Ytelse/pcb/DMPro16/Project Outputs for DMPro16/BOM documents/BOM/Modified Bill of Materials.csv

Quantity per card | Total quantity to order | Supplier 1 | Supplier Part Number 1 | Description | Supplier webpage
1 | 5 | Digikey | 1175-1612-ND | Box Header, Pitch 2.54 mm, 2x10 Position, Height 9 mm, Tail Length 3 mm | http://www.digikey.com/product-detail/en/cnc-tech/3020-20-0100-00/1175-1612-ND/3441738
n/a | 4 | Digikey | S2221E-36-ND | Breakaway dual row header | http://www.digikey.com/product-detail/en/sullins-connector-solutions/PBC36DFBN/S2221E-36-ND/861382
n/a | 10 | Digikey | S1211EC-40-ND | Breakaway single row header | http://www.digikey.com/product-detail/en/sullins-connector-solutions/PRPC040SFAN-RC/S1211EC-40-ND/2775334
1 | 10 | Digi-Key | P12.0KHCT-ND | 12K 0.1W 1% 0603 (1608 Metric) SMD | http://www.digikey.com/product-search/en?keywords=P12.0KHCT-ND
1 | 10 | Digi-Key | P20.0KHCT-ND | 20K 0.1W 1% 0603 (1608 Metric) SMD | http://www.digikey.com/product-search/en?keywords=P20.0KHCT-ND
1 | 5 | Digi-Key | WM17469-ND | 2 x 7 2mm pitch vertical header | http://www.digikey.com/product-search/en?keywords=WM17469-ND
1 | 10 | Digi-Key | P300KHCT-ND | 300K 0.1W 1% 0603 (1608 Metric) SMD | http://www.digikey.com/product-search/en?keywords=P300KHCT-ND
1 | 5 | Digi-Key | 732-3833-5-ND | WS-DITV 2.54 mm Compact THT Dip Switch with Raised Actuator | http://www.digikey.com/product-search/en?keywords=732-3833-5-ND
1 | 10 | Digi-Key | P45.3KHCT-ND | 45K3 0.1W 1% 0603 (1608 Metric) SMD | http://www.digikey.com/product-search/en?keywords=P45.3KHCT-ND
1 | 10 | Digi-Key | P6.65KHCT-ND | 6K65 0.1W 1% 0603 (1608 Metric) SMD | http://www.digikey.com/product-search/en?keywords=P6.65KHCT-ND
1 | 10 | Digi-Key | P820GCT-ND | 820R 0.1W 5% 0603 (1608 Metric) SMD | http://www.digikey.com/product-search/en?keywords=P820GCT-ND
1 | 10 | Digi-Key | 445-7486-1-ND | CAP 10uF 10V ±10% 0603 (1608 Metric) Thickness 1mm SMD | http://www.digikey.com/product-search/en?keywords=445-7486-1-ND
1 | 10 | Digi-Key | 311-1444-1-ND | CAP 1uF 16V ±10% 0603 (1608 Metric) Thickness 1mm SMD | http://www.digikey.com/product-search/en?keywords=311-1444-1-ND
1 | 5 | Digi-Key | 768-1007-1-ND | USB UART Asynchronous Serial Data Transfer Chip, SSOP-28, Tape and Reel | http://www.digikey.com/product-search/en?keywords=768-1007-1-ND
1 | 6 | Digi-Key | 631-1185-1-ND | 24 MHz oscillator | http://www.digikey.com/product-search/en?keywords=631-1185-1-ND
1 | 5 | Digi-Key | LT6700HVCS6-3#TRMPBFCT-ND | Micropower, Low Voltage, Comparator with 400 mV Reference, 2 Channels, 1.4 to 36 V, -40 to +85 degC, 6-pin TSOT-23 (S6), Tape and Reel | http://www.digikey.com/product-search/en?keywords=LT6700HVCS6-3%23TRMPBFCT-ND
1 | 5 | Digi-Key | 557-1562-ND | 128 Mb (x1/x2/x4) Serial NOR Flash Memory with Multi I/O, 108 MHz, 2.7 to 3.6 V, 8-pin SO8 Wide (SE), Tray | http://www.digikey.com/product-search/en?keywords=557-1562-ND
1 | 5 | Digi-Key | 277-1667-ND | Socket, Screw Terminal Block, 2 Way, 5.0 mm Pitch, 90 Degree Angle, Through-Hole | http://www.digikey.com/product-search/en?keywords=277-1667-ND
1 | 6 | Digi-Key | 296-23557-1-ND | Advanced USB Transceiver, Full Speed, Single, +/-15 KV, -40 to 85 degC, 14-Pin TSSOP (PW) | http://www.digikey.com/product-search/en?keywords=296-23557-1-ND
1 | 6 | Digi-Key | USB3300-EZK-CT-ND | Hi-Speed USB Host, Device or OTG PHY with ULPI Low Pin Interface, 5 pF, -40 to 85 degC, 32-Pin QFN (QFN-3304), RoHS, Tape and Reel | http://www.digikey.com/product-search/en?keywords=USB3300-EZK-CT-ND
12 | 60 | Digi-Key | 478-7943-1-ND | CAP 4.7uF 10V ±10% 0603 (1608 Metric) Thickness 1mm SMD | http://www.digikey.com/product-search/en?keywords=478-7943-1-ND
16 | 80 | Digi-Key | 541-470GCT-ND | 470R 0.1W 5% 0603 (1608 Metric) SMD | http://www.digikey.com/product-search/en?keywords=541-470GCT-ND
17 | 85 | Digi-Key | 732-4978-1-ND | SMD mono-color Chip LED, WL-SMCW, Red | http://www.digikey.com/product-search/en?keywords=732-4978-1-ND
2 | 20 | Digi-Key | 541-15GCT-ND | 15R 0.1W 5% 0603 (1608 Metric) SMD | http://www.digikey.com/product-search/en?keywords=541-15GCT-ND
2 | 20 | Digi-Key | 541-1.20KHCT-ND | 1K2 0.1W 1% 0603 (1608 Metric) SMD | http://www.digikey.com/product-search/en?keywords=541-1.20KHCT-ND
2 | 20 | Digi-Key | P1.8KGCT-ND | 1K8 0.1W 5% 0603 (1608 Metric) SMD | http://www.digikey.com/product-search/en?keywords=P1.8KGCT-ND
2 | 20 | Digi-Key | P200GCT-ND | 200R 0.1W 5% 0603 (1608 Metric) SMD | http://www.digikey.com/product-search/en?keywords=P200GCT-ND
22 | 110 | Digi-Key | 311-1776-1-ND | CAP 100nF 16V ±5% 0603 (1608 Metric) Thickness 1mm SMD | http://www.digikey.com/product-search/en?keywords=311-1776-1-ND
3 | 30 | Digi-Key | P4.7KGCT-ND | 4K7 0.1W 5% 0603 (1608 Metric) SMD | http://www.digikey.com/product-search/en?keywords=P4.7KGCT-ND
3 | 15 | Digi-Key | SW415-ND | Sealed Tactile Switch, SPST-NO, 3 to 24 V, -25 to 70 degC, 4-Pin SMD, RoHS, Bulk | http://www.digikey.com/product-search/en?keywords=SW415-ND
3 | 30 | Digi-Key | 478-6208-1-ND | CAP 10nF 16V ±1% 0603 (1608 Metric) Thickness 1mm SMD | http://www.digikey.com/product-detail/en/avx-corporation/0603YC103JAT2A/478-6208-1-ND/2391407
3 | 30 | Digi-Key | 445-7474-1-ND | CAP 2.2uF 16V ±10% 0603 (1608 Metric) Thickness 0.55mm SMD | http://www.digikey.com/product-search/en?keywords=445-7474-1-ND
3 | 15 | Digi-Key | LP38501TS-ADJ-ND | 3A FlexCap Low Dropout Linear Regulator for 2.7V to 5.5V Inputs, 5-pin TO-263, Pb-Free | http://www.digikey.com/product-search/en?keywords=LP38501TS-ADJ-ND
4 | 30 | Digi-Key | 541-33GCT-ND | 33R 0.1W 5% 0603 (1608 Metric) SMD | http://www.digikey.com/product-search/en?keywords=541-33GCT-ND
4 | 30 | Digi-Key | P4.70KHCT-ND | 4K7 0.1W 1% 0603 (1608 Metric) SMD | http://www.digikey.com/product-search/en?keywords=P4.70KHCT-ND
4 | 30 | Digi-Key | 445-9050-1-ND | CAP 4.7uF 16V ±10% 0603 (1608 Metric) Thickness 1mm SMD | http://www.digikey.com/product-detail/en/tdk-corporation/C1608X5R1E475K080AC/445-9050-1-ND/3648704
5 | 40 | Digi-Key | P100KHCT-ND | 100K 0.1W 1% 0603 (1608 Metric) SMD | http://www.digikey.com/product-search/en?keywords=P100KHCT-ND
5 | 40 | Digi-Key | 541-100GCT-ND | 100R 0.1W 5% 0603 (1608 Metric) SMD | http://www.digikey.com/product-search/en?keywords=541-100GCT-ND
5 | 40 | Digi-Key | P1.0KGCT-ND | 1K 0.1W 5% 0603 (1608 Metric) SMD | http://www.digikey.com/product-search/en?keywords=P1.0KGCT-ND
5 | 25 | Digi-Key | WM5461CT-ND | USB, MINI, SMD, RA KME04-USBMU03A01 | http://www.digikey.com/product-search/en?keywords=WM5461CT-ND
5 | 25 | Digi-Key | 568-3529-2-ND | 4 channel USB ESD protection device | http://www.digikey.com/product-search/en?keywords=568-3529-2-ND
6 | 30 | Digi-Key | 445-6007-1-ND | CAP 100uF 10V ±20% 1206 (3216 Metric) Thickness 1.9mm SMD | http://www.digikey.com/product-search/en?keywords=445-6007-1-ND
7 | 50 | Digi-Key | 541-10.0KHCT-ND | 10K 0.1W 1% 0603 (1608 Metric) SMD | http://www.digikey.com/product-search/en?keywords=541-10.0KHCT-ND
7 | 50 | Digi-Key | 311-10KGRCT-ND | 10K 0.1W 5% 0603 (1608 Metric) SMD | http://www.digikey.com/product-search/en?keywords=311-10KGRCT-ND
8 | 40 | Digi-Key | 490-3390-1-ND | 1210 100uF capacitor for artix-7 power decoupling | http://www.digikey.com/product-search/en?keywords=490-3390-1-ND
8 | 40 | Digi-Key | 541-0.0GCT-ND | Jumper 0603 (1608 Metric) | http://www.digikey.com/product-search/en?keywords=541-0.0GCT-ND
1 | 5 | Farnell | 2064067 | SD and Combo Memory Card Connector, 9 Position Surface Mount, -25 to 85 degC, RoHS, Tape and Reel | http://no.farnell.com/molex/503500-0991/connector-sd-card-push-push-smt/dp/2064067?ost=2064067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
1 | 6 | Farnell | 1641012RL | 48 MHz oscillator | http://no.farnell.com/fox-electronics/fxo-hc736r-48/osc-5x7mm-smd-cer-48-000mhz/dp/1641012
23 | 115 | Farnell | 1833805 | CAP 470nF 10V ±5% 0603 (1608 Metric) Thickness 1mm SMD | http://no.farnell.com/avx/0603zd474kat2a/cap-mlcc-x5r-470nf-10v-0603/dp/1833805?ost=1833805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
3 | 30 | Farnell | 2496834 | CAP 15pF 16V ±0.25pF 0603 (1608 Metric) Thickness 1mm SMD | http://no.farnell.com/walsin/0603b104k500ct/capacitor-mlcc-x7r-0-1uf-50v-0603/dp/2496834?ost=2496834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
5 | 35 | Farnell | 1833809 | CAP 1uF 16V ±5% 0603 (1608 Metric) Thickness 1mm SMD | http://no.farnell.com/avx/0603zg105zat2a/cap-mlcc-y5v-1uf-10v-0603/dp/1833809?ost=1833809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
1 | 6 | Farnell | 2064049 | 100 MHz oscillaor | http://no.farnell.com/fox-electronics/fxo-hc736r-100/osc-100mhz-3-3v-smd/dp/2064049
