Ytelse/pcb/DMPro16/Project Outputs for DMPro16/Documentation Output/Schematic Print/Schematic Prints.PDF

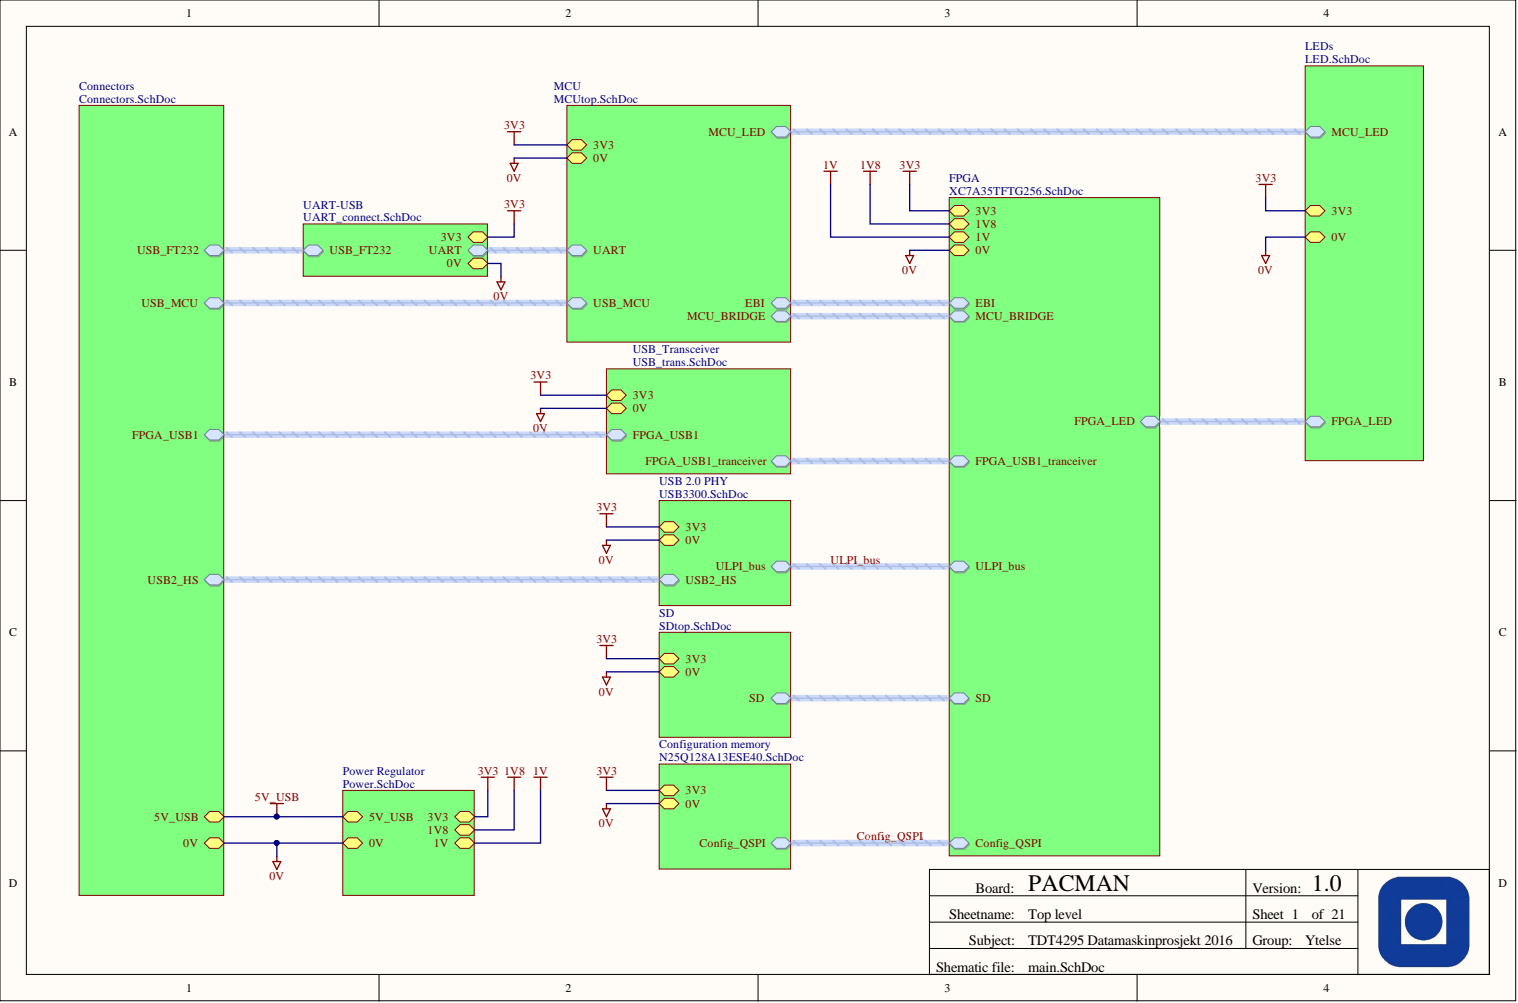
[picture p1: page 1]

5V_USB 3V3 1V8 0V 1V

Board: PACMAN | Version: 1.0

Sheetname: Top level | Sheet 1 of 21

Subject: TDT4295 Datamaskinprosjekt 2016 | Group: Ytelse

Shematic file: main.SchDoc

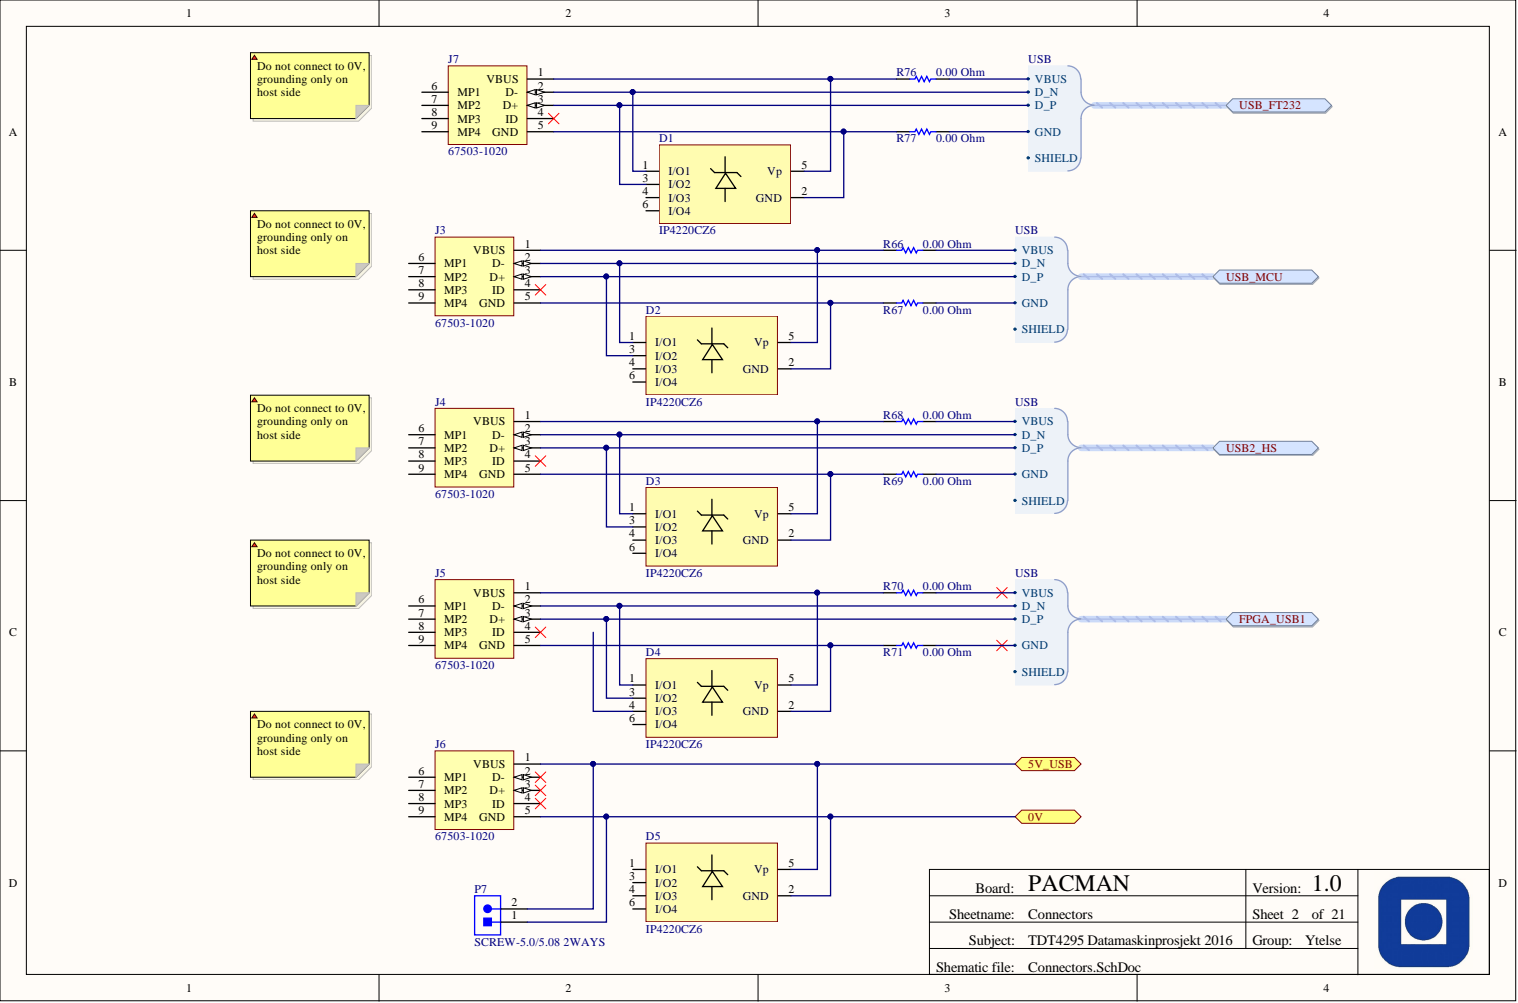
[picture p2: page 2]

Do not connect to 0V,
grounding only on
host side

Shematic file: Connectors.SchDoc

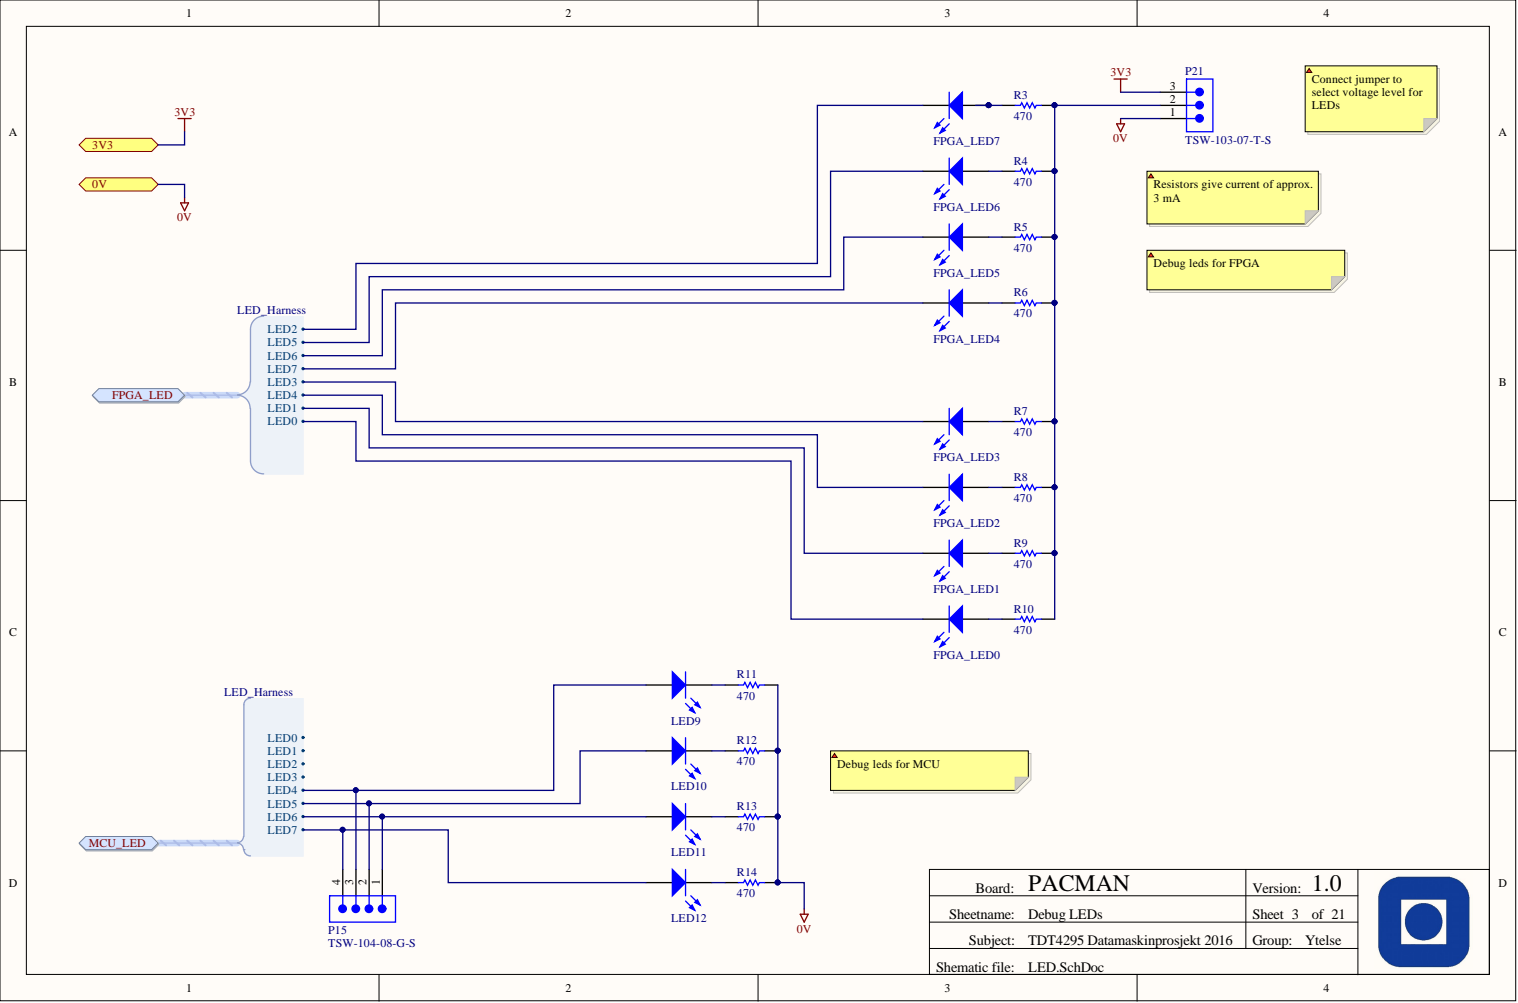
[picture p3: page 3]

Connect jumper to
select voltage level for
LEDs

Resistors give current of approx.

Debug leds for FPGA

Debug leds for MCU

Board: PACMAN | Version: 1.0

Sheetname: Debug LEDs | Sheet 3 of 21

Shematic file: LED.SchDoc

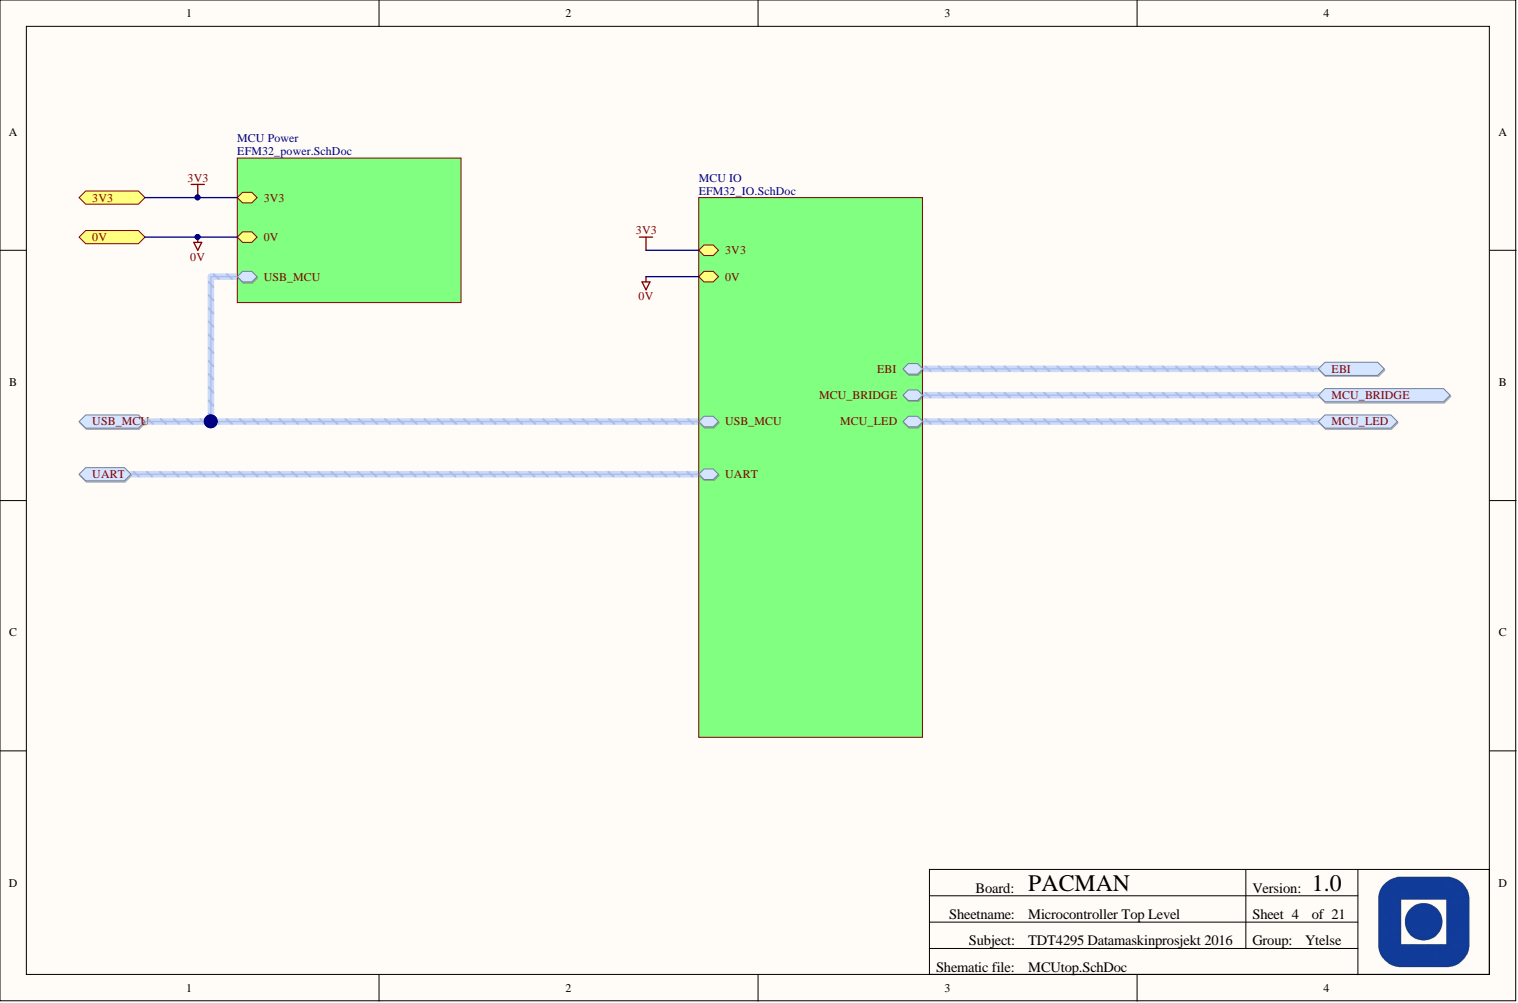
[picture p4: page 4]

: PACMAN Bo ard | : 1.0 V ersio n

S h e etn am e : Micro c o ntroller To p Le v e l | S h e e t 4 o f 2 1

u bje ct: TDT4 5 D ata askin prosje kt 2 | Gro p Ytelse

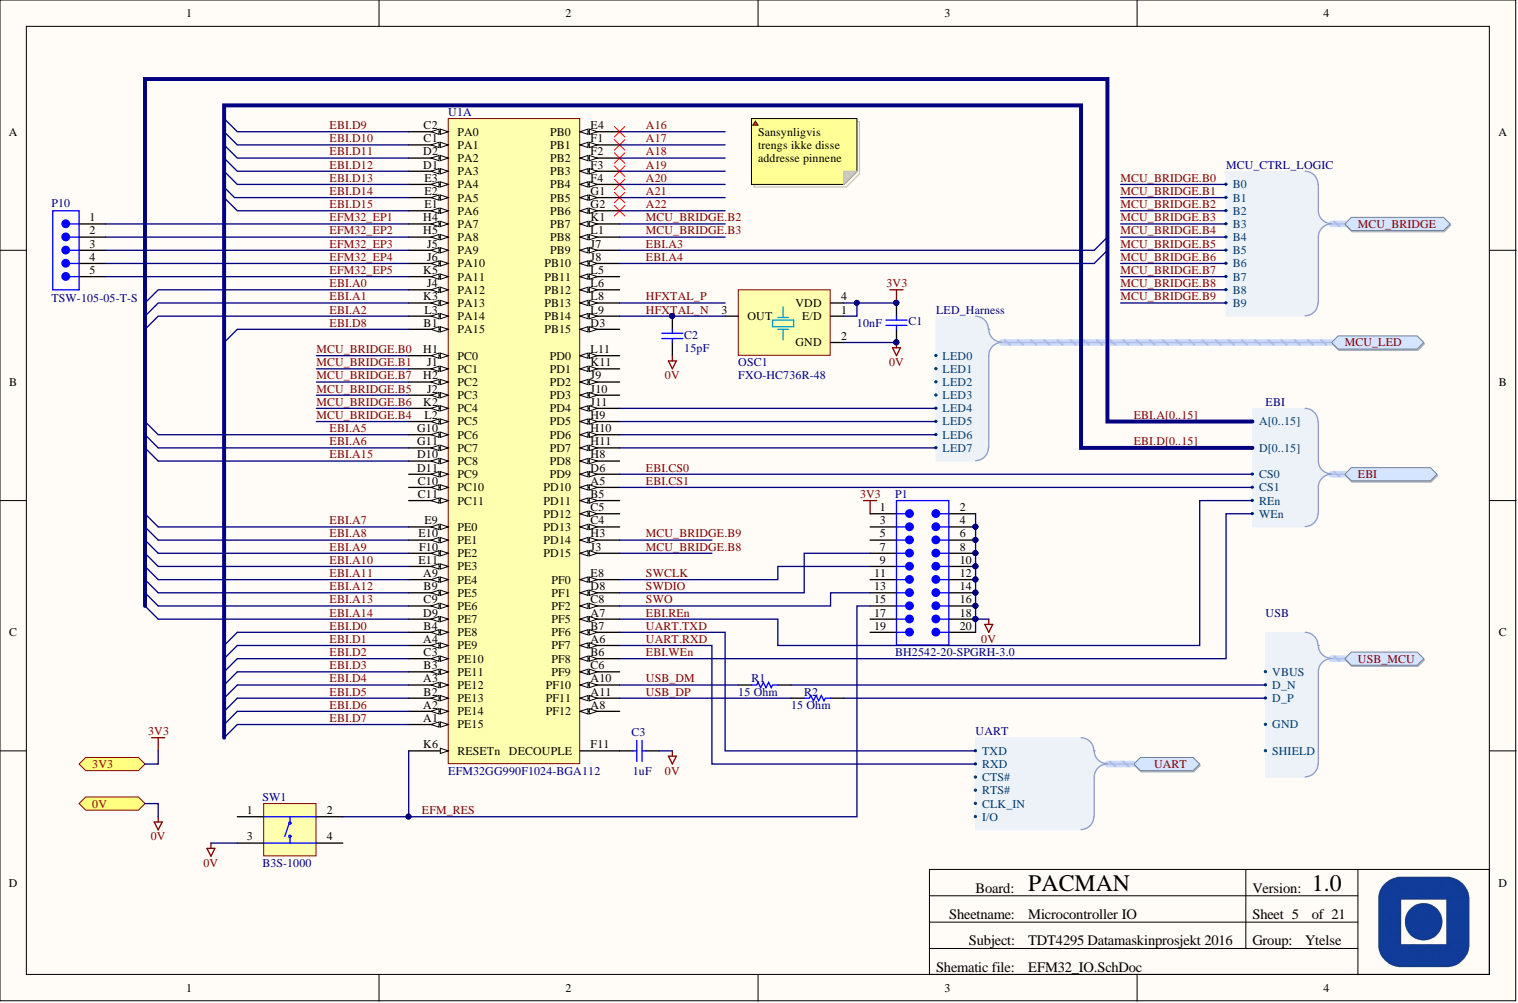
[picture p5: page 5]

EBI.CS0 EBI.CS1 EBI.WEn EBI.REn

MCU _BRID G E.B9 MCU _BRID G E.B8 | 3 5 7 | | 4 6 8 1 0 1 2 1 4 1 6

EBI.A | 1 4 D 9 | PE 7 PF5 8 B4 PF6 PE PE 9 PF7 0 C3 PF8 PE 1 1 B3 PF9 PE 1 PE 1 2 PF1 0 3 B2 PE 1 PF1 1 PE 1 4 PF1 2 PE 1 5 | A 7 | | 1 7 1 9 | 1 8 2 0
EBI.D EBI.D EBI.D EBI.D | 0 1 A 4 2 3 4 A 3 5 6 A 2 1 7 A | | B7 | U ART.T X D

A 6 | U ART.RX D

B6 | | | BH 2 5 4 2-2
C6 | USB_ D M R1 USB_ D P 1 5 O h m R2 1 5 O h m C3 | | U ART

: PACMAN Bo ard | : 1.0 V ersio n

S h e etn am e : Micro c o ntroller IO | S h e e t 5 o f 2 1

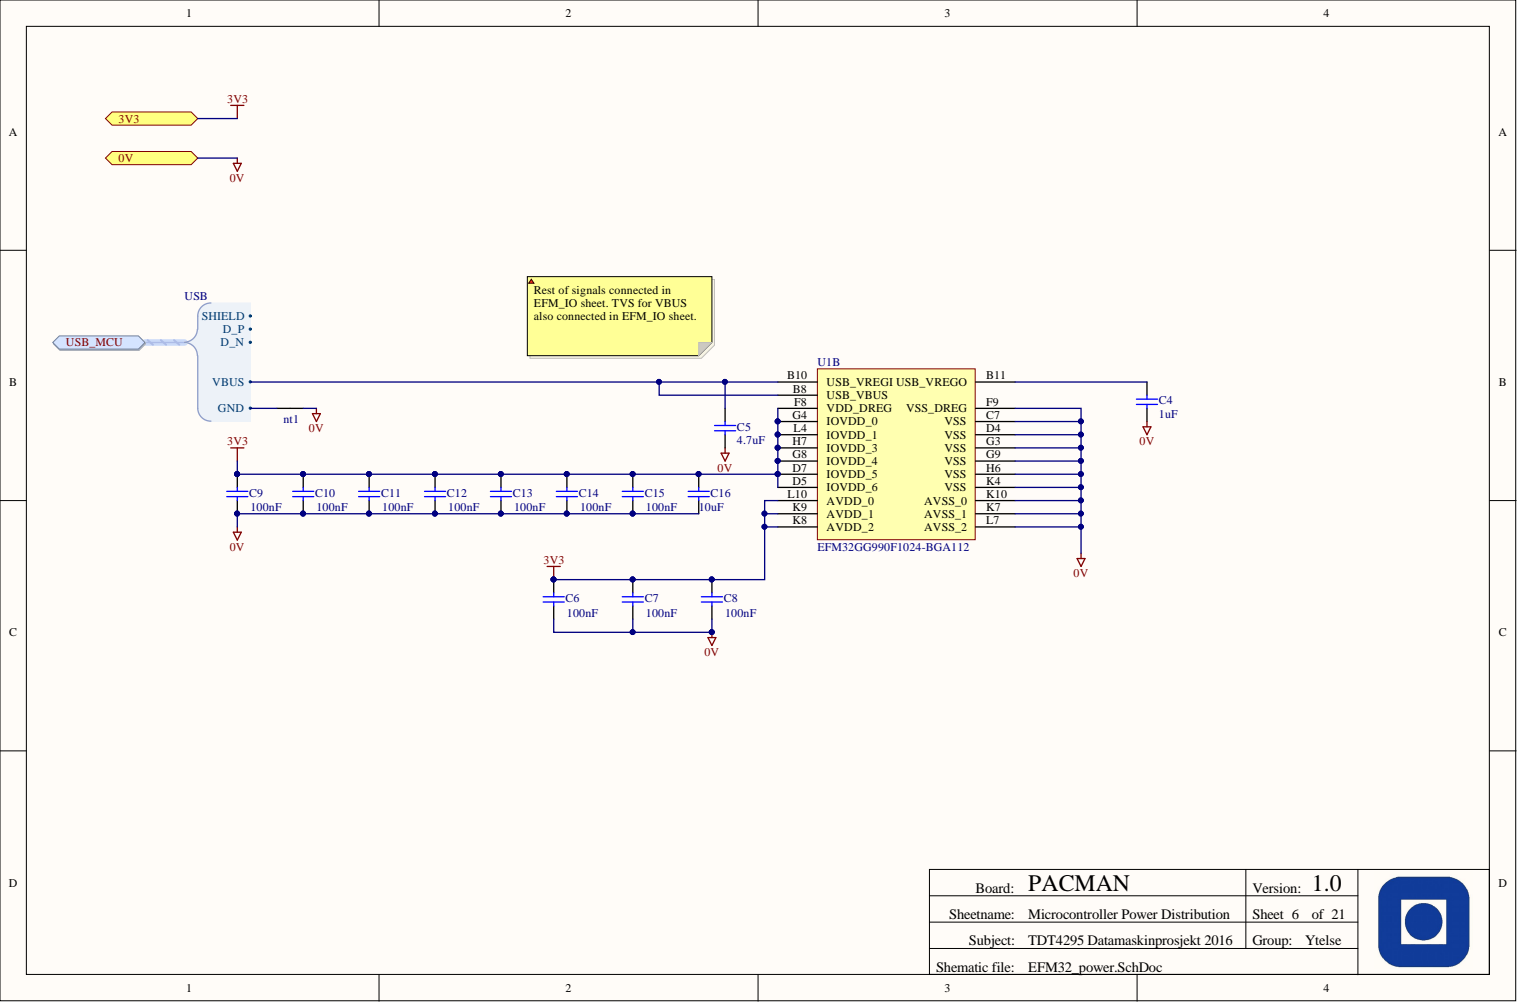
[picture p6: page 6]

Rest of signals connected in
EFM_IO sheet. TVS for VBUS
also connected in EFM_IO sheet.

Board: PACMAN | Version: 1.0

Sheetname: Microcontroller Power Distribution | Sheet 6 of 21

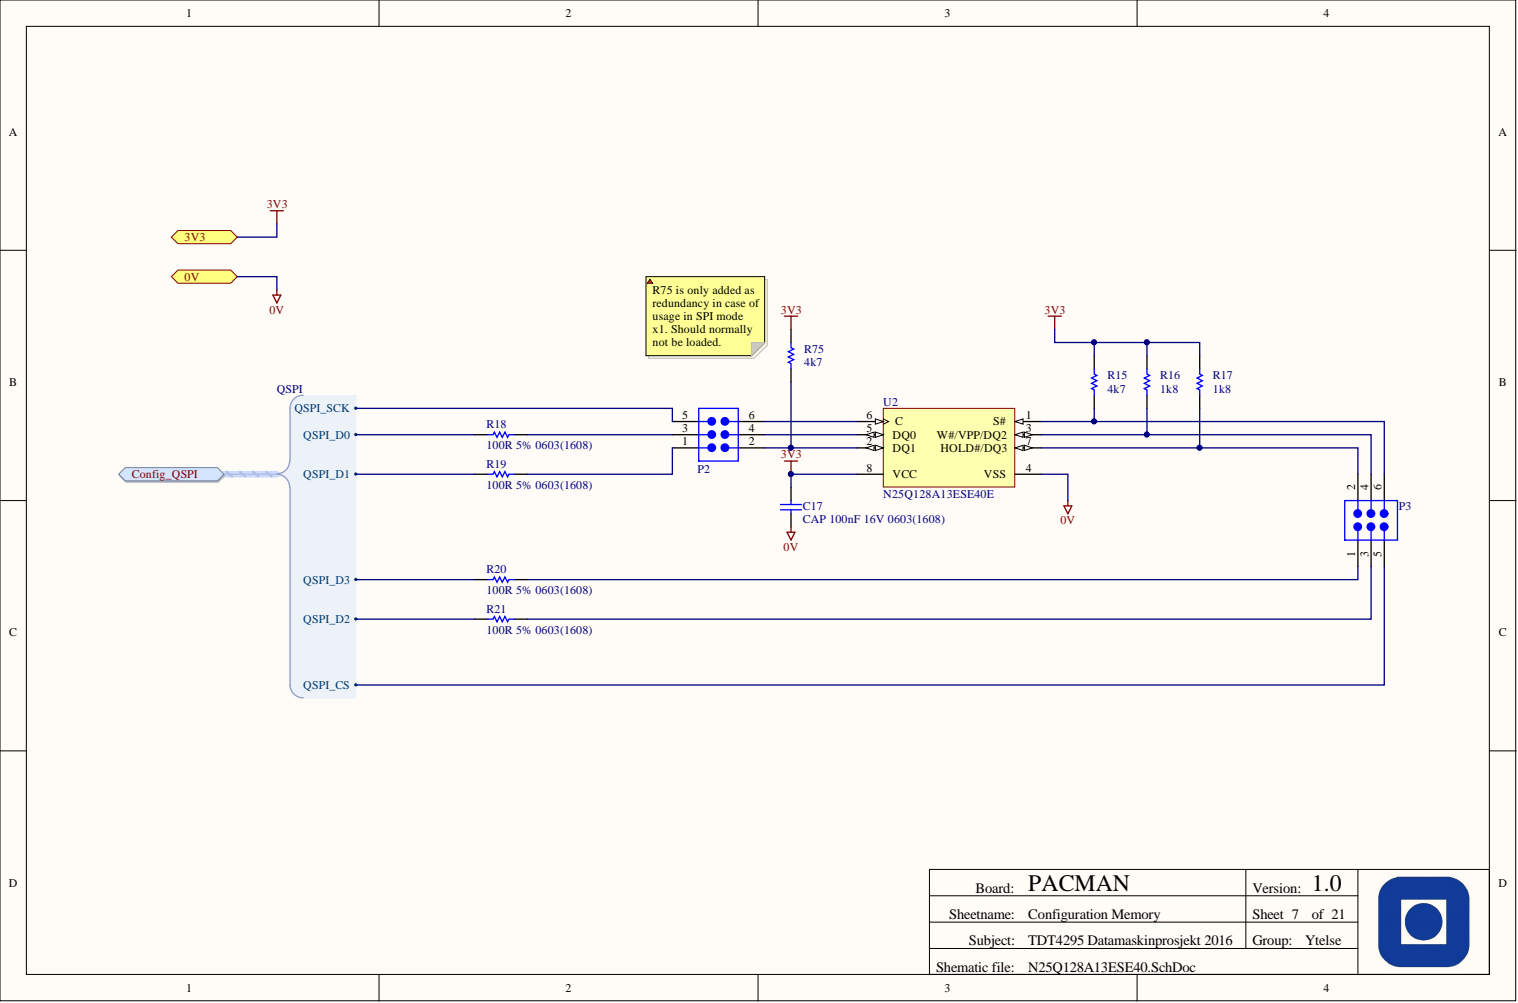
[picture p7: page 7]

: PACMAN Bo ard | : 1.0 V ersio n

S h e etn am e : Co nfig uratio n M e m ory | S h e e t 7 o f 2 1

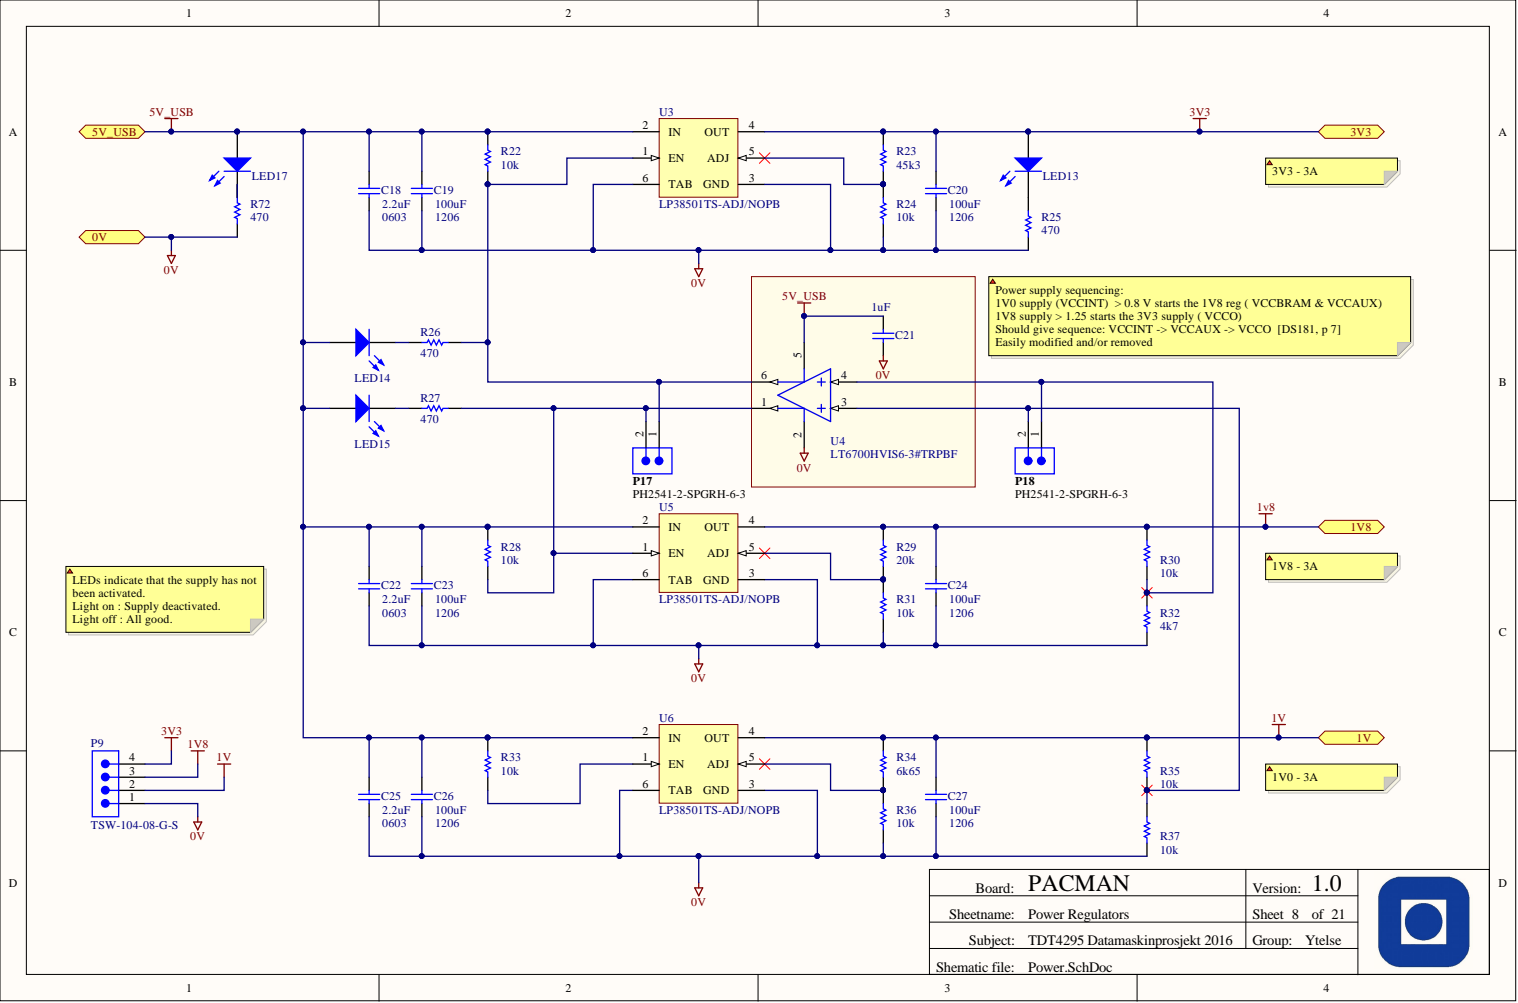
[picture p8: page 8]

R2 8 | 1
1 0 k | 6 | 3

R3 3 | 1
1 0 k | 6 | | 3

: PACMAN Bo ard | : 1.0 V ersio n

S h e etn am e : P o w er Re g ulators | S h e e t 8 o f 2 1

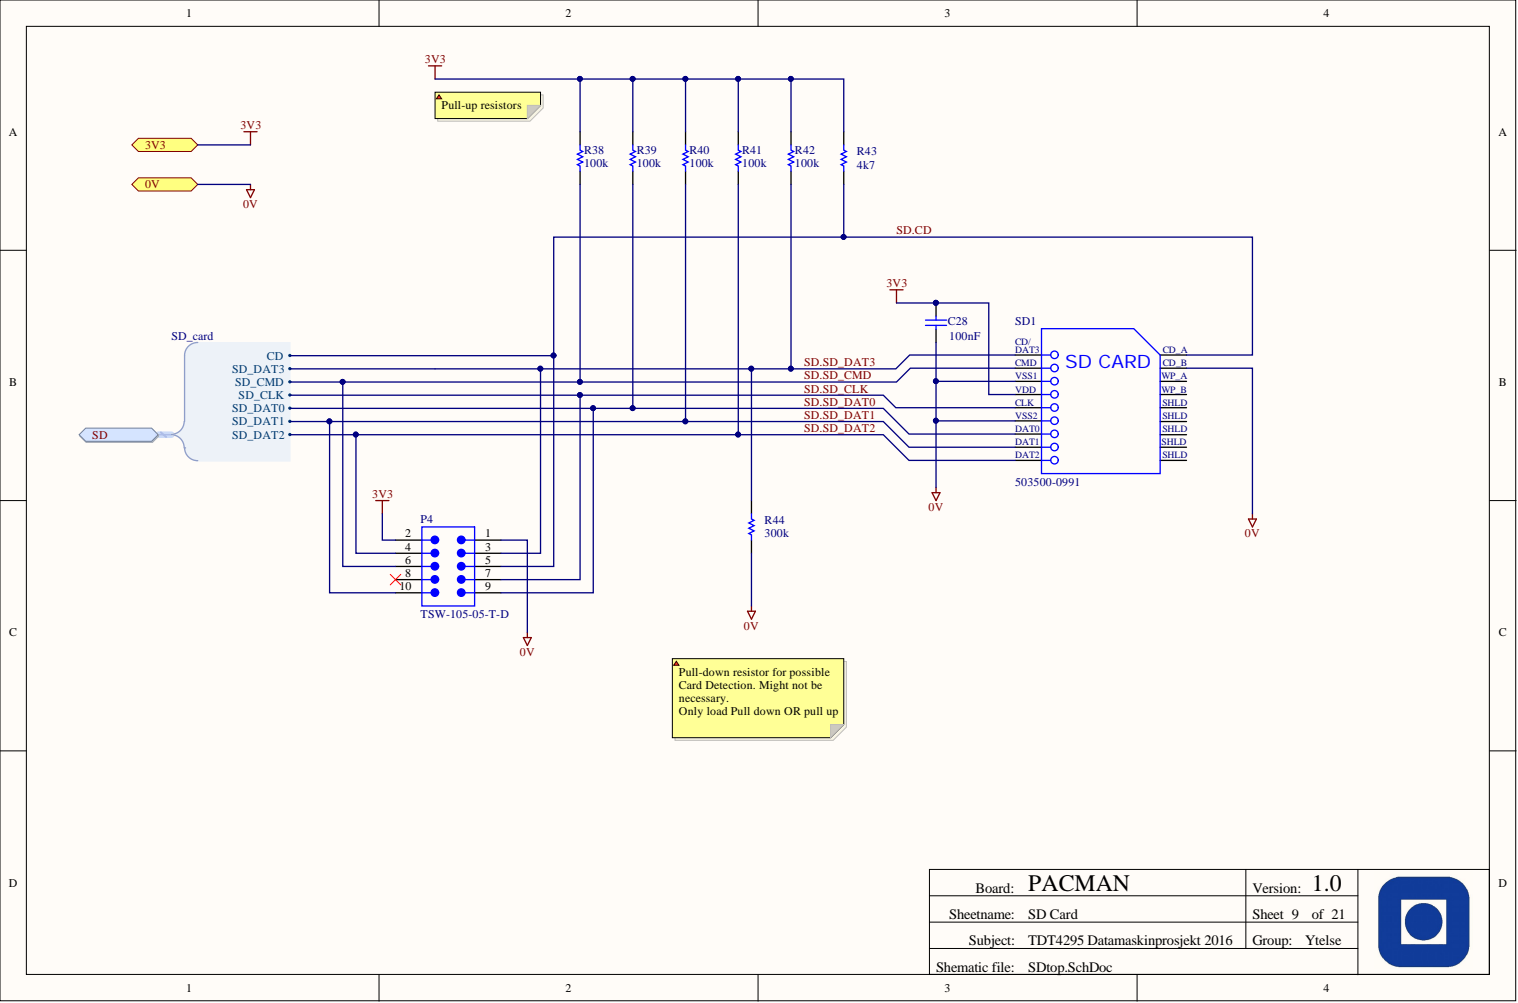
[picture p9: page 9]

Pull-down resistor for possible
Card Detection. Might not be
necessary.
Only load Pull down OR pull up

Board: PACMAN | Version: 1.0

Sheetname: SD Card | Sheet 9 of 21

Shematic file: SDtop.SchDoc

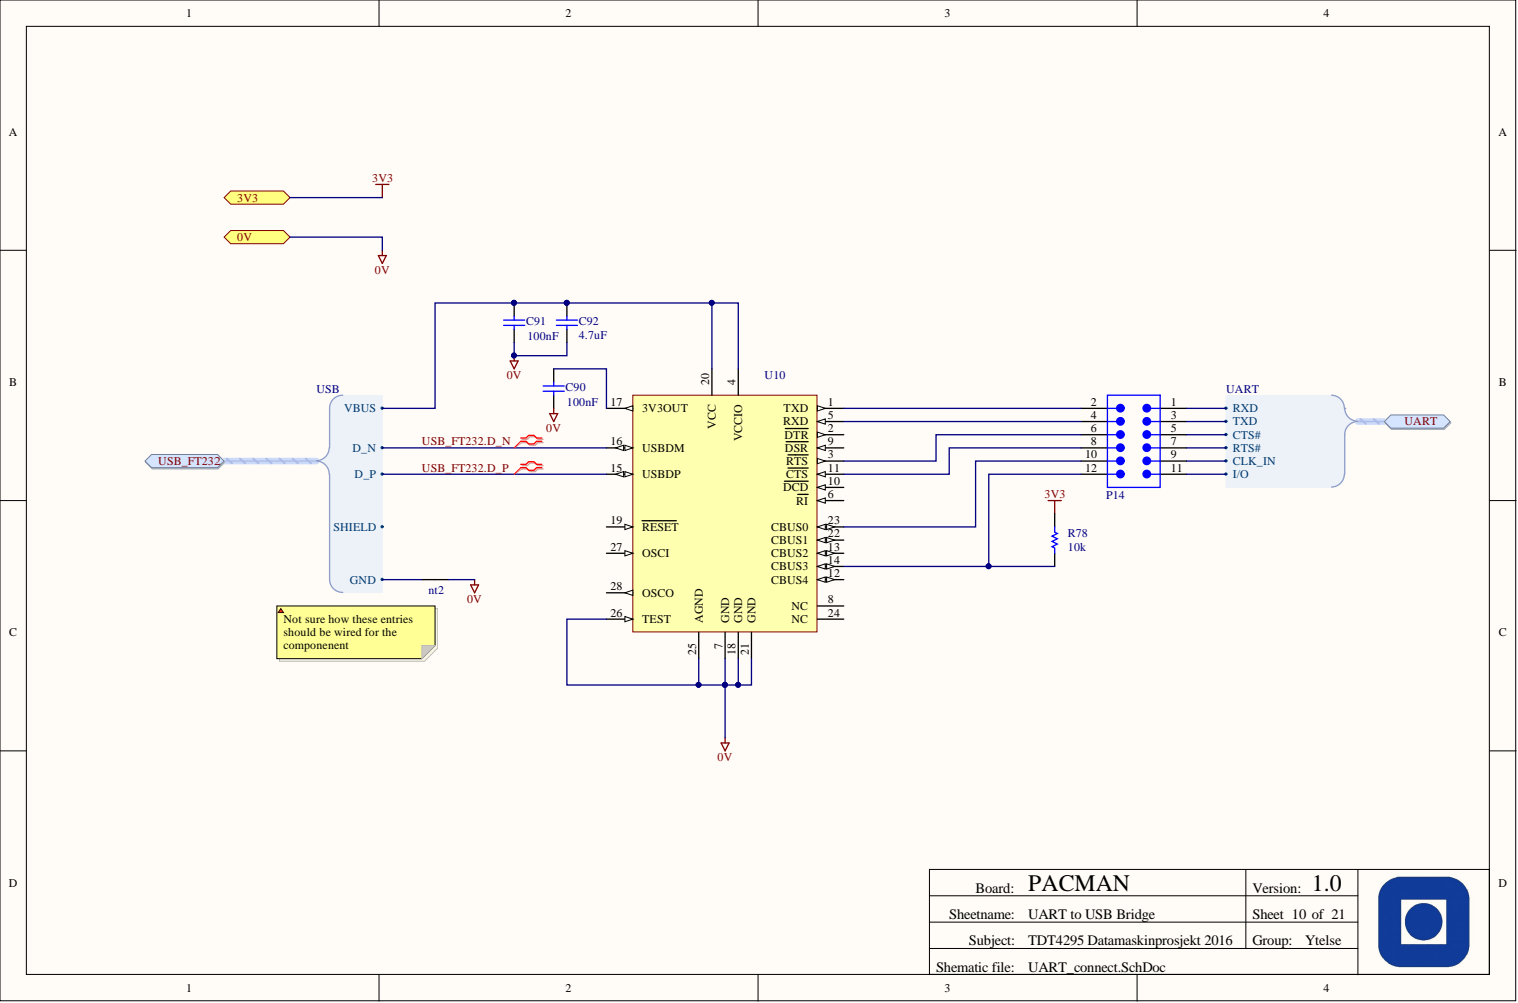
[picture p10: page 10]

: PACMAN Bo ard | : 1.0 V ersio n

S h e etn am e : U ART to U SB Brid g e | S h e e t 1 0 o f 2 1

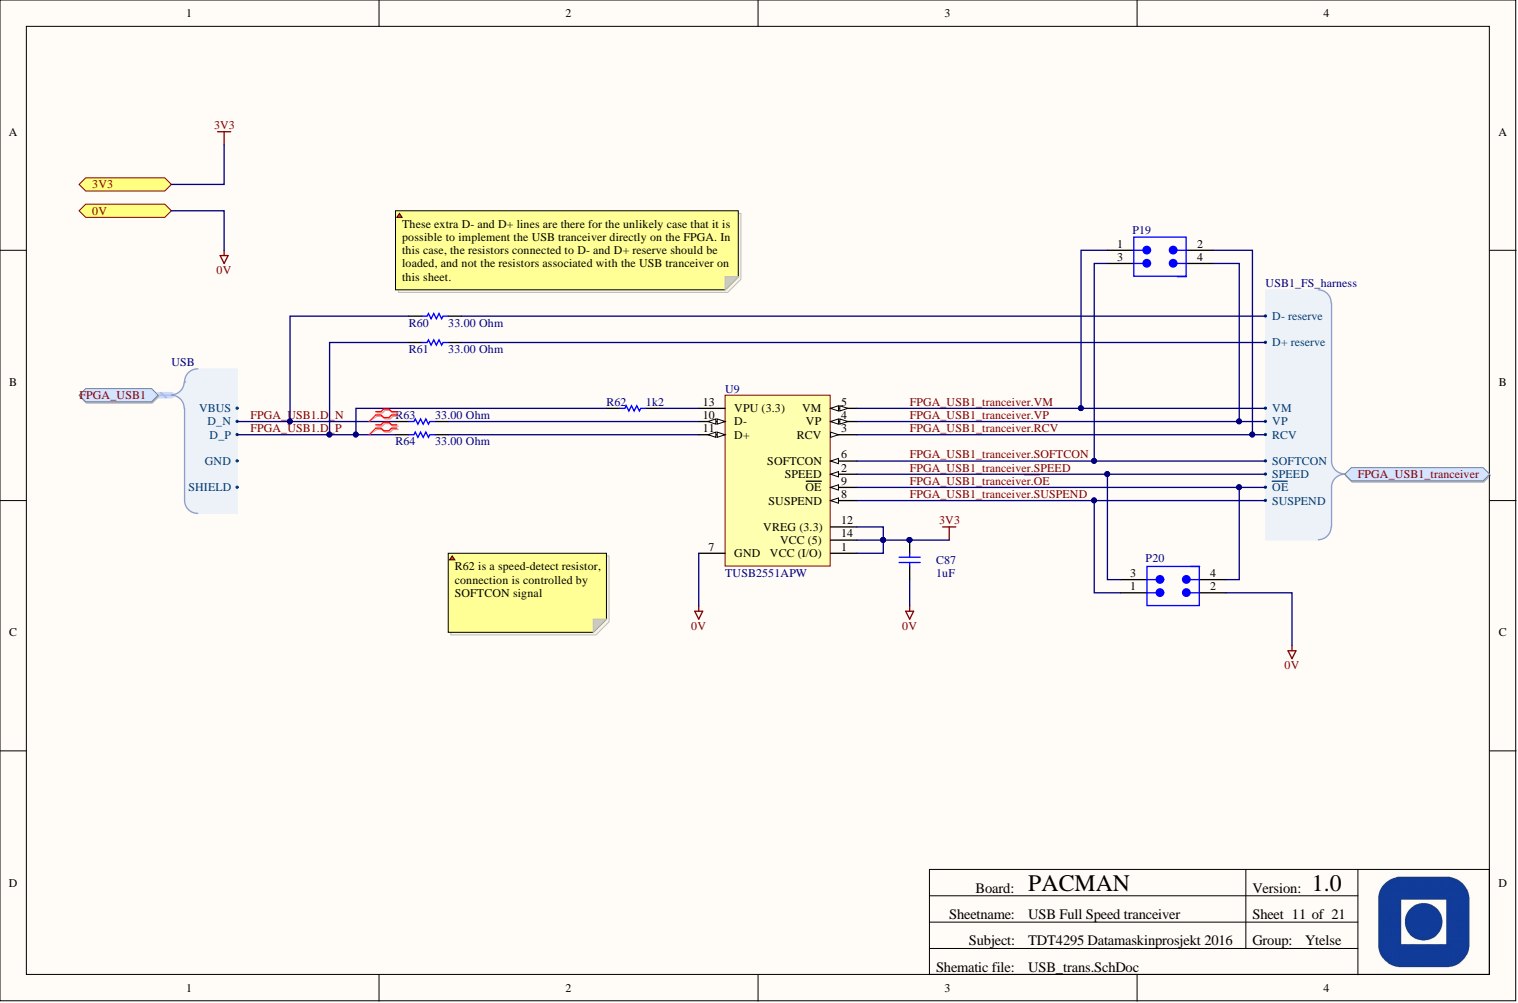
[picture p11: page 11]

These extra D- and D+ lines are there for the unlikely case that it is
possible to implement the USB tranceiver directly on the FPGA. In
this case, the resistors connected to D- and D+ reserve should be
loaded, and not the resistors associated with the USB tranceiver on
this sheet.

R62 is a speed-detect resistor,
connection is controlled by
SOFTCON signal

Board: PACMAN | Version: 1.0

Sheetname: USB Full Speed tranceiver | Sheet 11 of 21

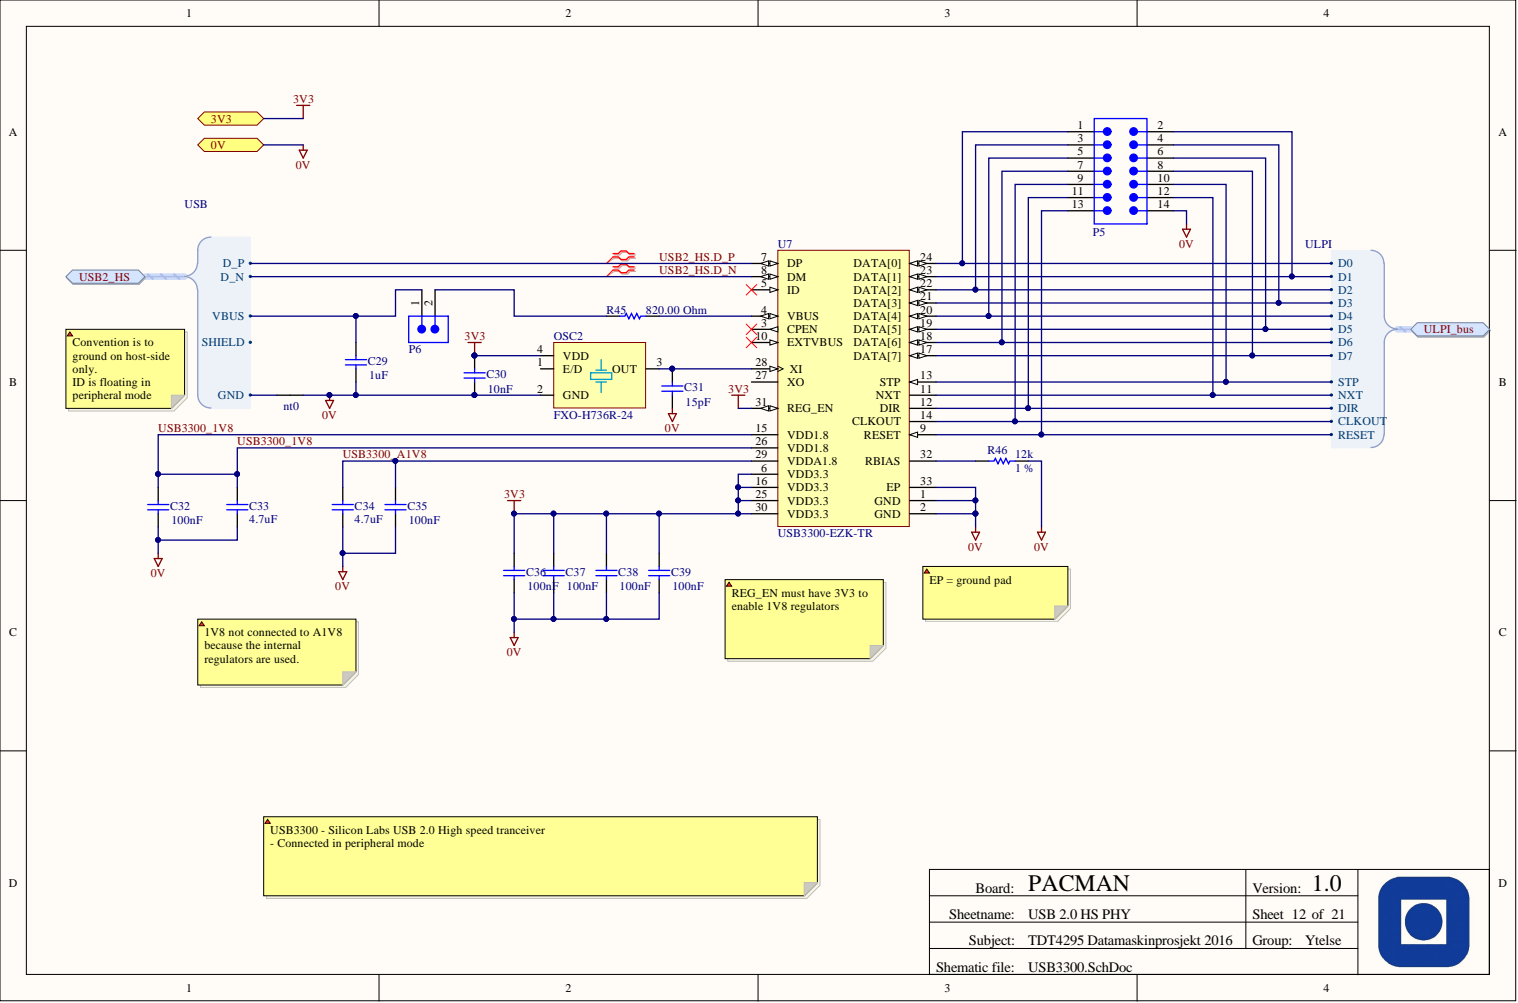
[picture p12: page 12]

1 0
1 2
1 4

USB3 3 0 0 _ 1 V 8 | 2 6

6 | 3 3
1 6
2 5 | 1
3 0 | 2

: PACMAN Bo ard | : 1.0 V ersio n

S h e etn am e : U SB 2.0 H S P H Y | S h e e t 1 2 o f 2 1

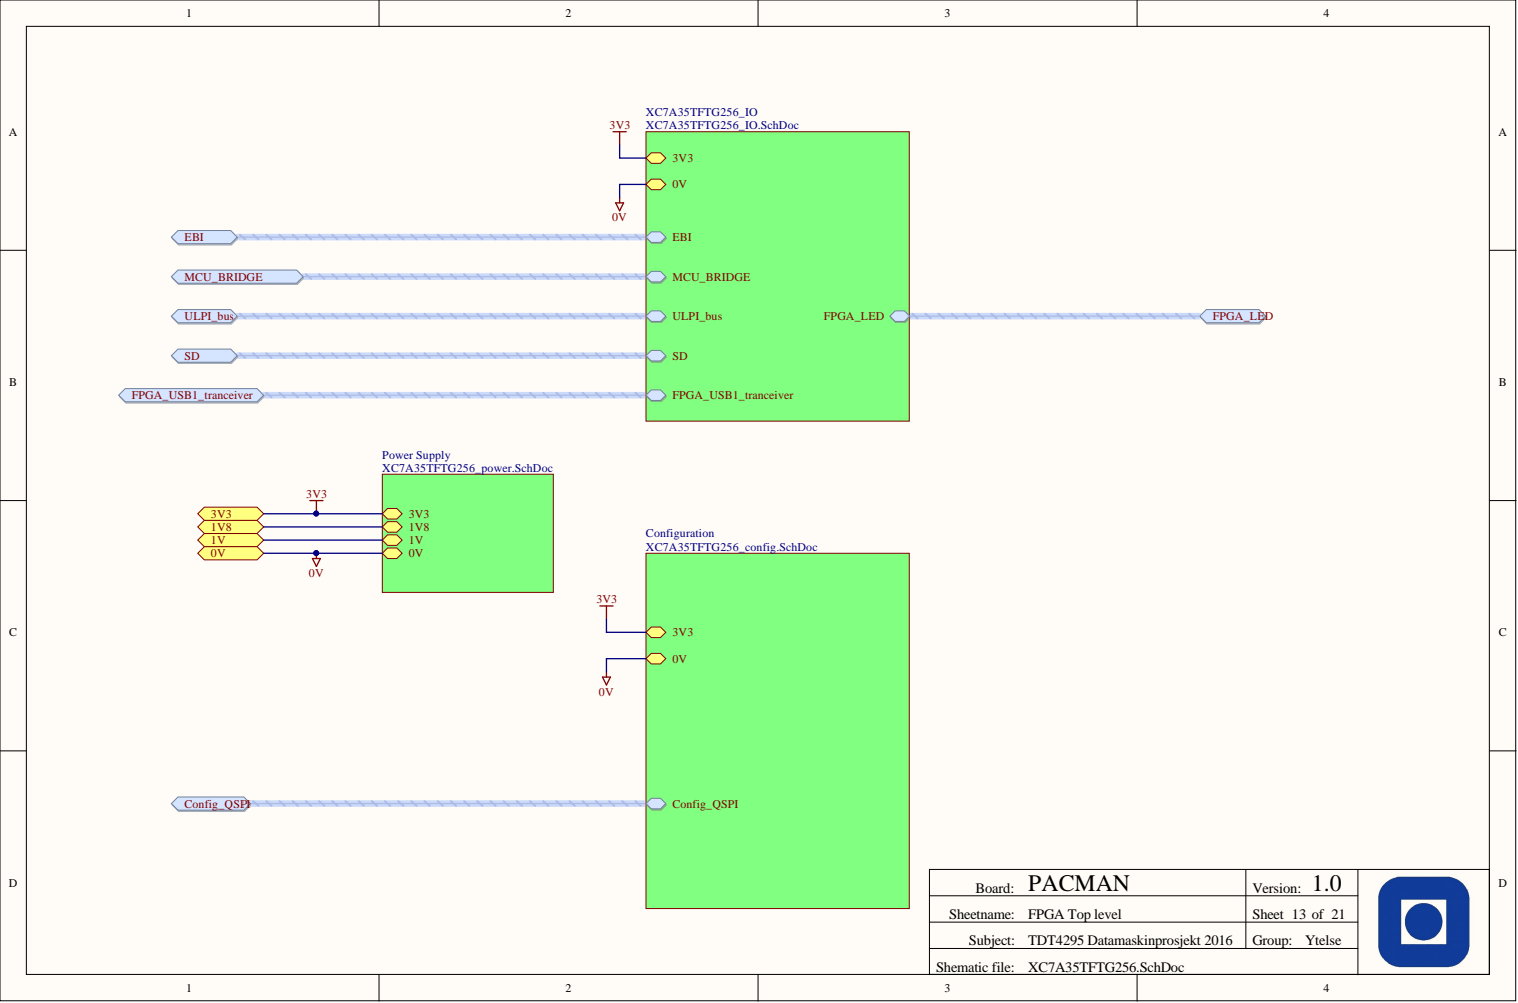
[picture p13: page 13]

Board: PACMAN | Version: 1.0

Sheetname: FPGA Top level | Sheet 13 of 21

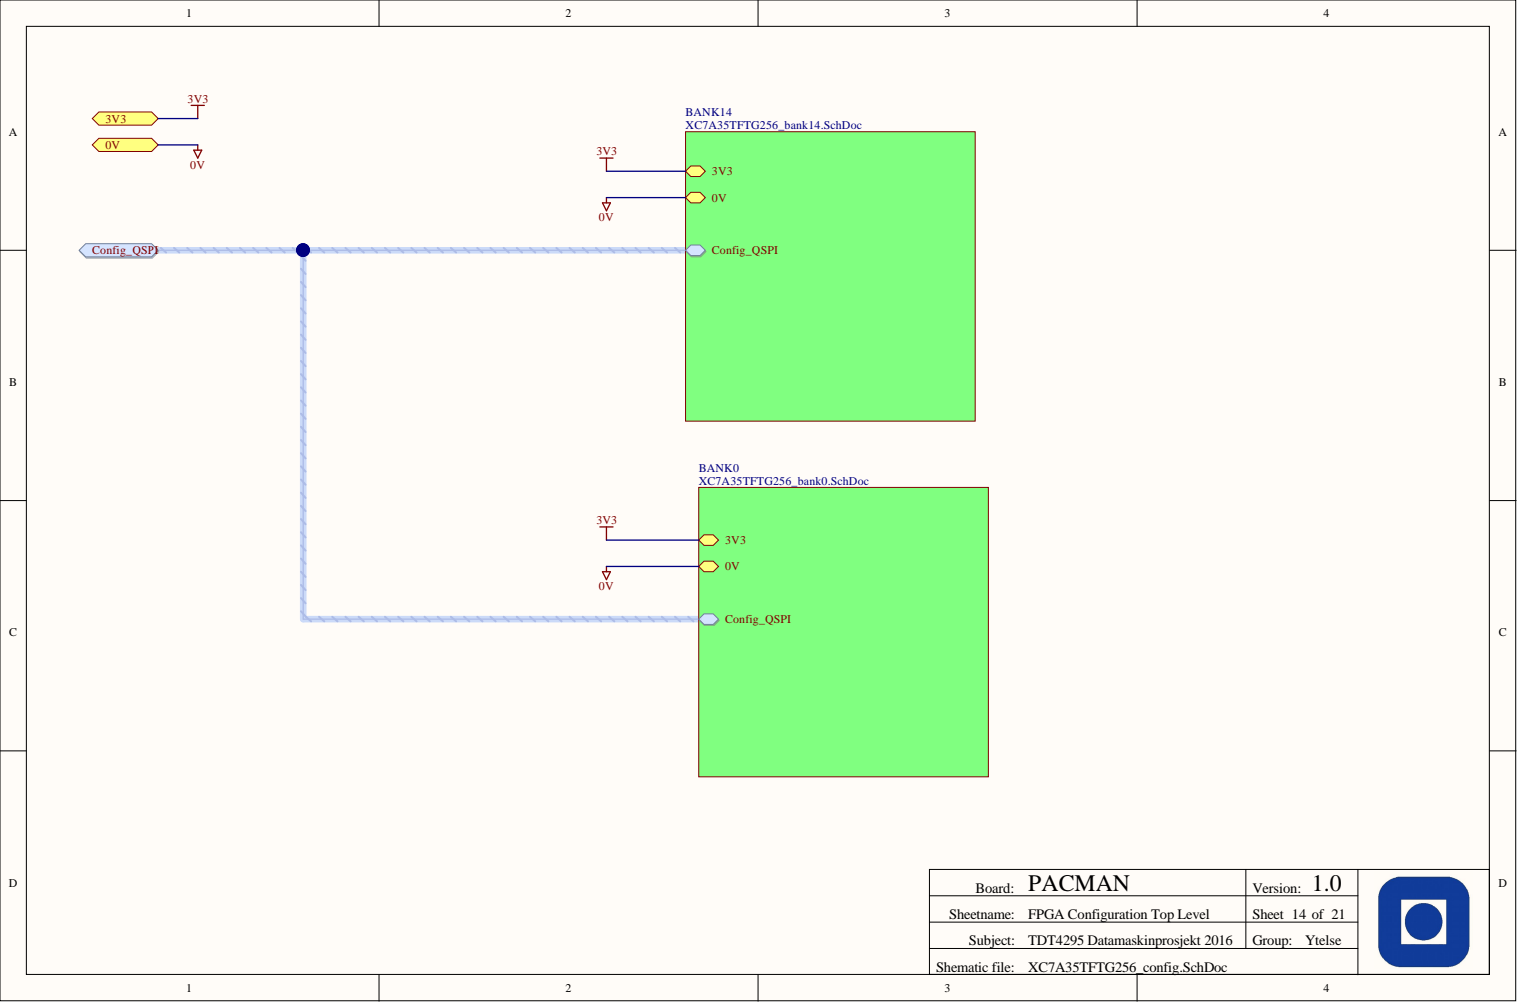
[picture p14: page 14]

Board: PACMAN | Version: 1.0

Sheetname: FPGA Configuration Top Level | Sheet 14 of 21

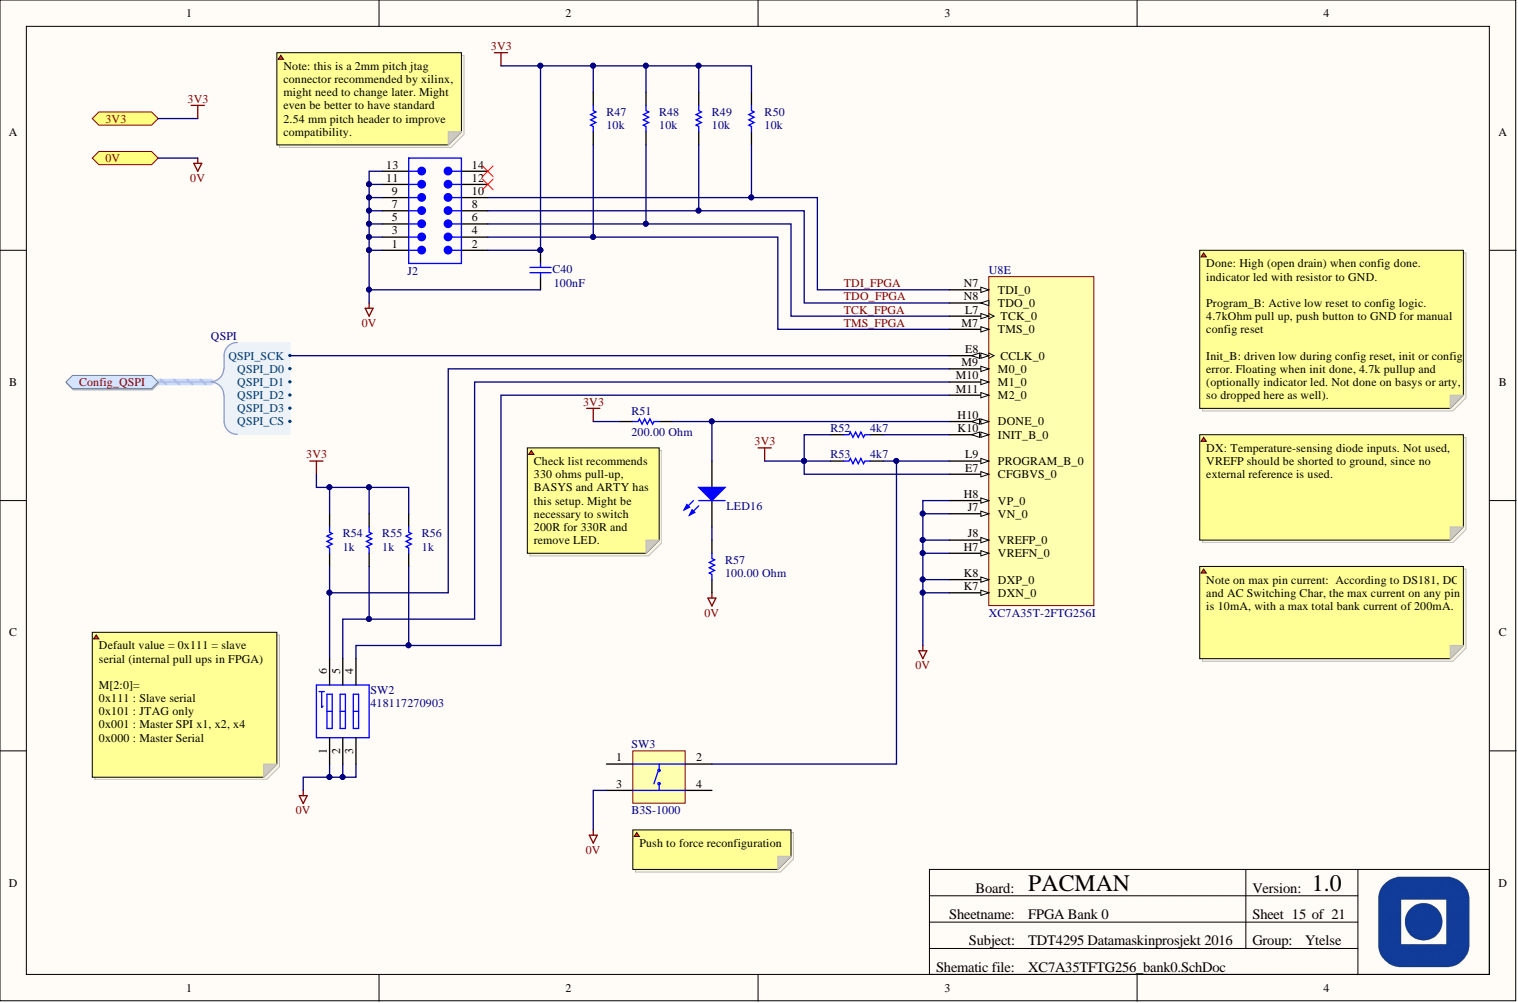
[picture p15: page 15]

Note: this is a 2mm pitch jtag
connector recommended by xilinx,
might need to change later. Might
even be better to have standard
2.54 mm pitch header to improve
compatibility.

Done: High (open drain) when config done.
indicator led with resistor to GND.

TDO_FPGA | TDO_0 N8
TCK_FPGA | TCK_0 L7
TMS_FPGA | TMS_0 M7

Program_B: Active low reset to config logic.
4.7kOhm pull up, push button to GND for manual
config reset

Init_B: driven low during config reset, init or config
error. Floating when init done, 4.7k pullup and
(optionally indicator led. Not done on basys or arty,
so dropped here as well).

M1_0 M10
M2_0 M11

3V3 | | DONE_0 H10 INIT_B_0 K10

DX: Temperature-sensing diode inputs. Not used,
VREFP should be shorted to ground, since no
external reference is used.

Check list recommends
330 ohms pull-up,
BASYS and ARTY has
this setup. Might be
necessary to switch
200R for 330R and
remove LED.

LED16 R57 100.00 Ohm | | CFGBVS_0 E7 PROGRAM_B_0 L9

VP_0 H8
VN_0 J7

VREFP_0 J8
VREFN_0 H7

Note on max pin current: According to DS181, DC
and AC Switching Char, the max current on any pin
is 10mA, with a max total bank current of 200mA.

DXN_0 K7

Default value = 0x111 = slave
serial (internal pull ups in FPGA)

Push to force reconfiguration

Board: PACMAN | Version: 1.0

Sheetname: FPGA Bank 0 | Sheet 15 of 21

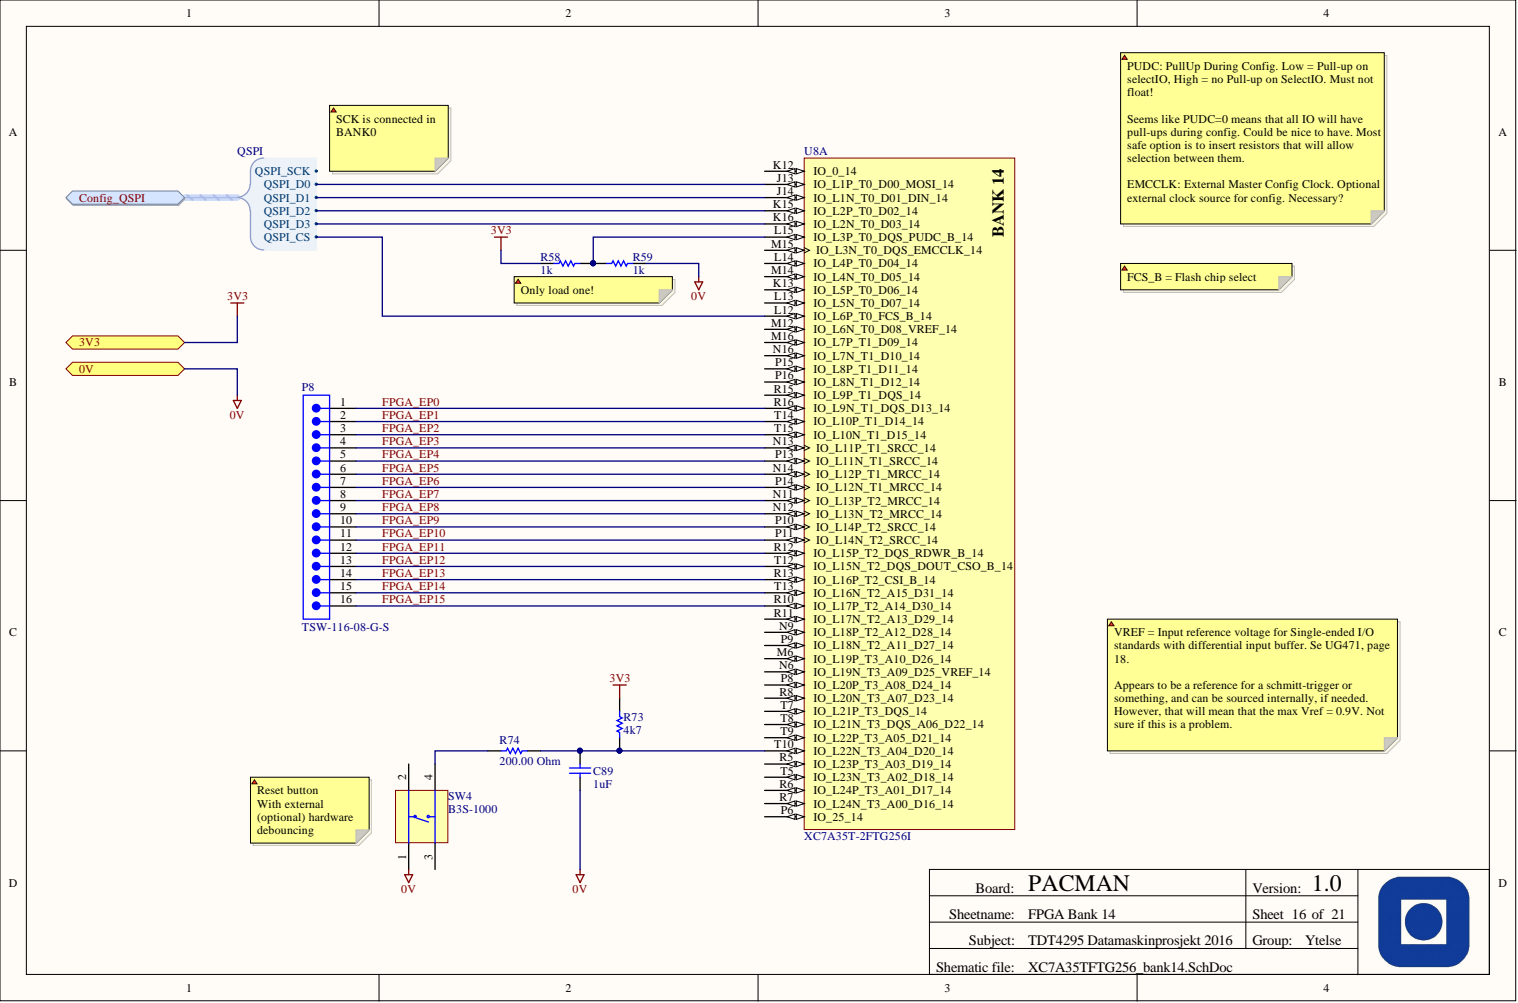
[picture p16: page 16]

: PACMAN Bo ard | : 1.0 V ersio n

S h e etn am e : F P G A Ba n k 1 4 | S h e e t 1 6 o f 2 1

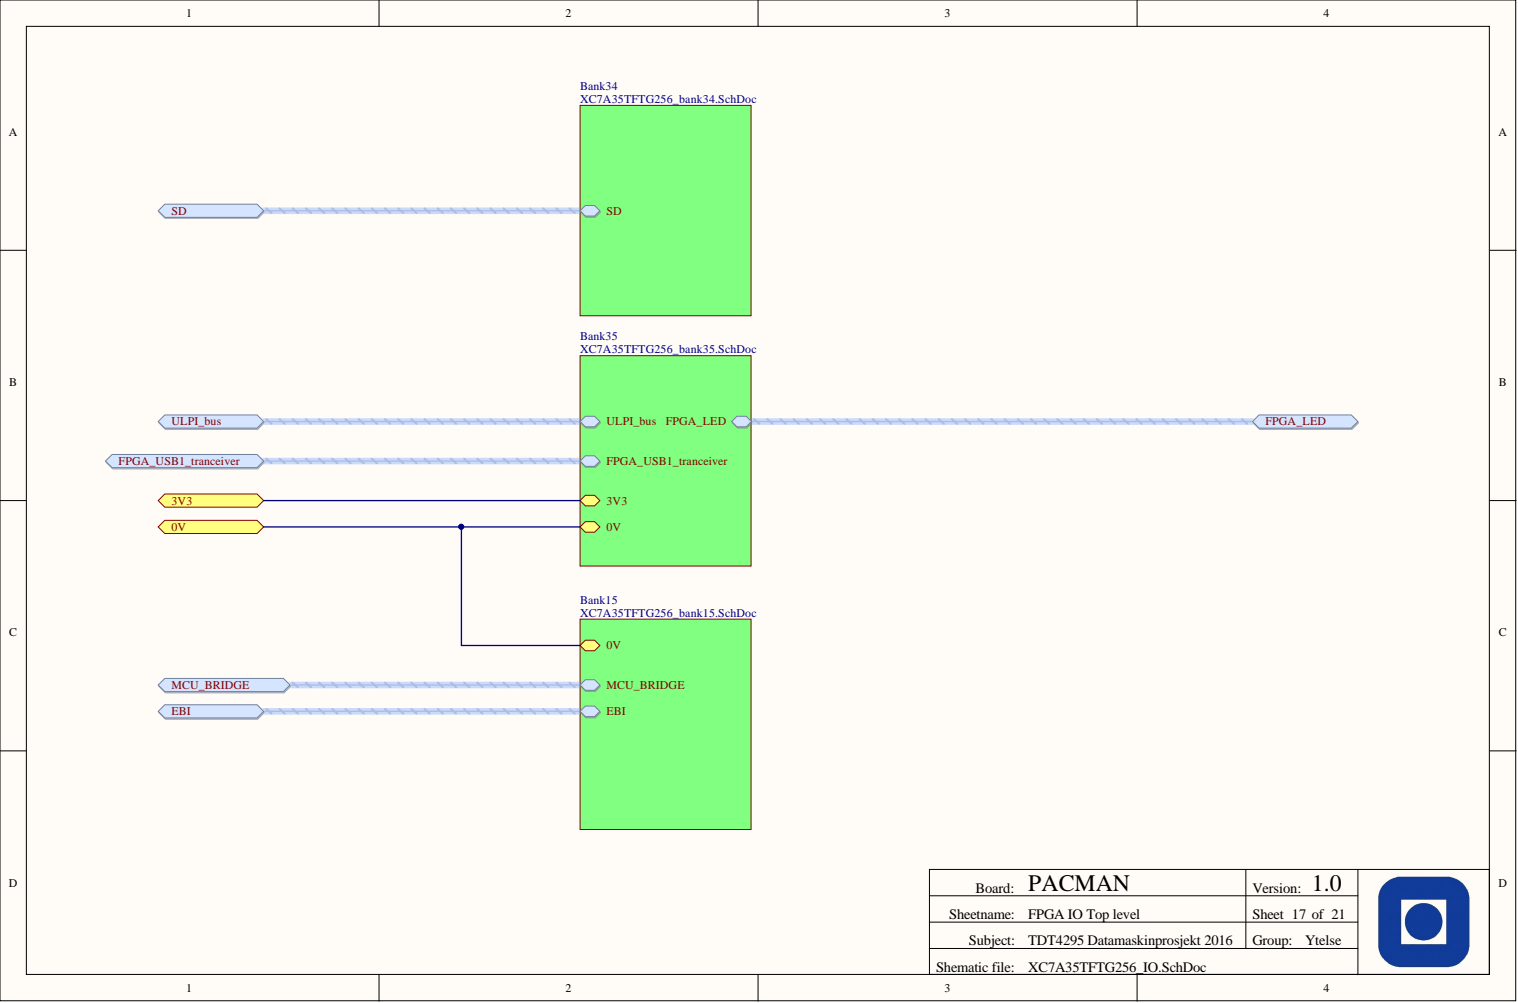
[picture p17: page 17]

Board: PACMAN | Version: 1.0

Sheetname: FPGA IO Top level | Sheet 17 of 21

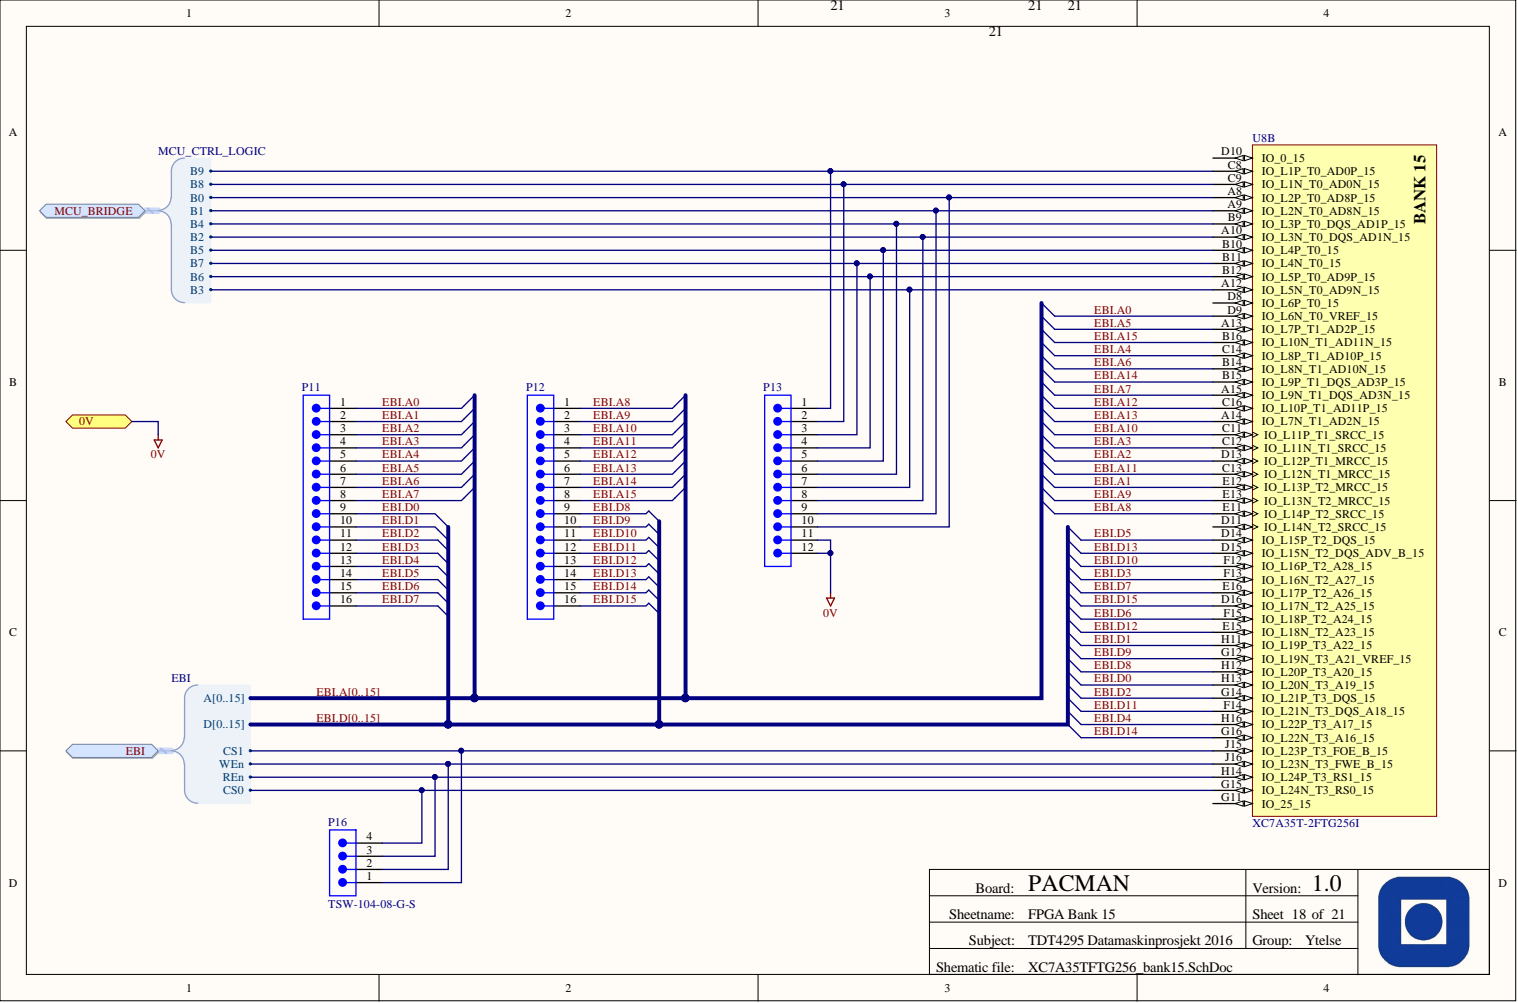
[picture p18: page 18]

EBI.A[0..1 | 5 ]

EBI.D[0..1 5 ]

J 1 6
H 1 4
G 1 5

: PACMAN Bo ard | : 1.0 V ersio n

S h e etn am e : F P G A Ba n k 1 5 | S h e e t 1 8 o f 2 1

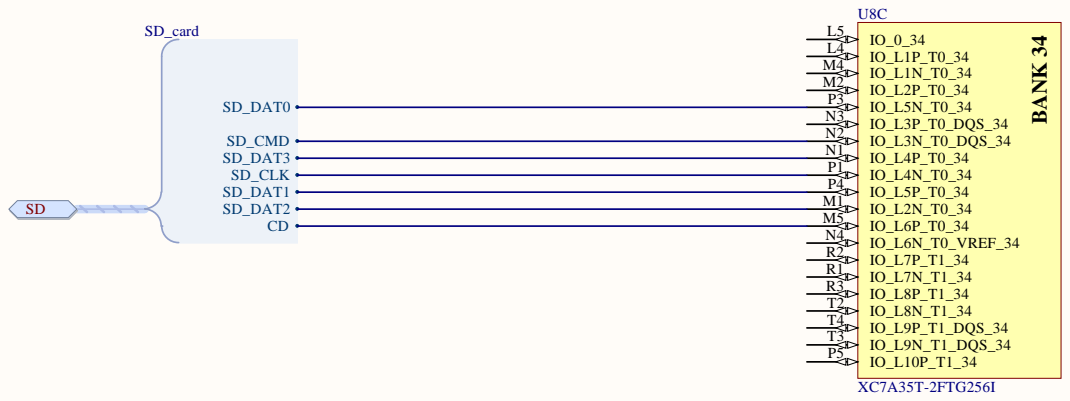
[picture p19: page 19]

: PACMAN Bo ard | : 1.0 V ersio n

S h e etn am e : F P G A Ba n k 3 4 | S h e e t 1 9 o f 2 1

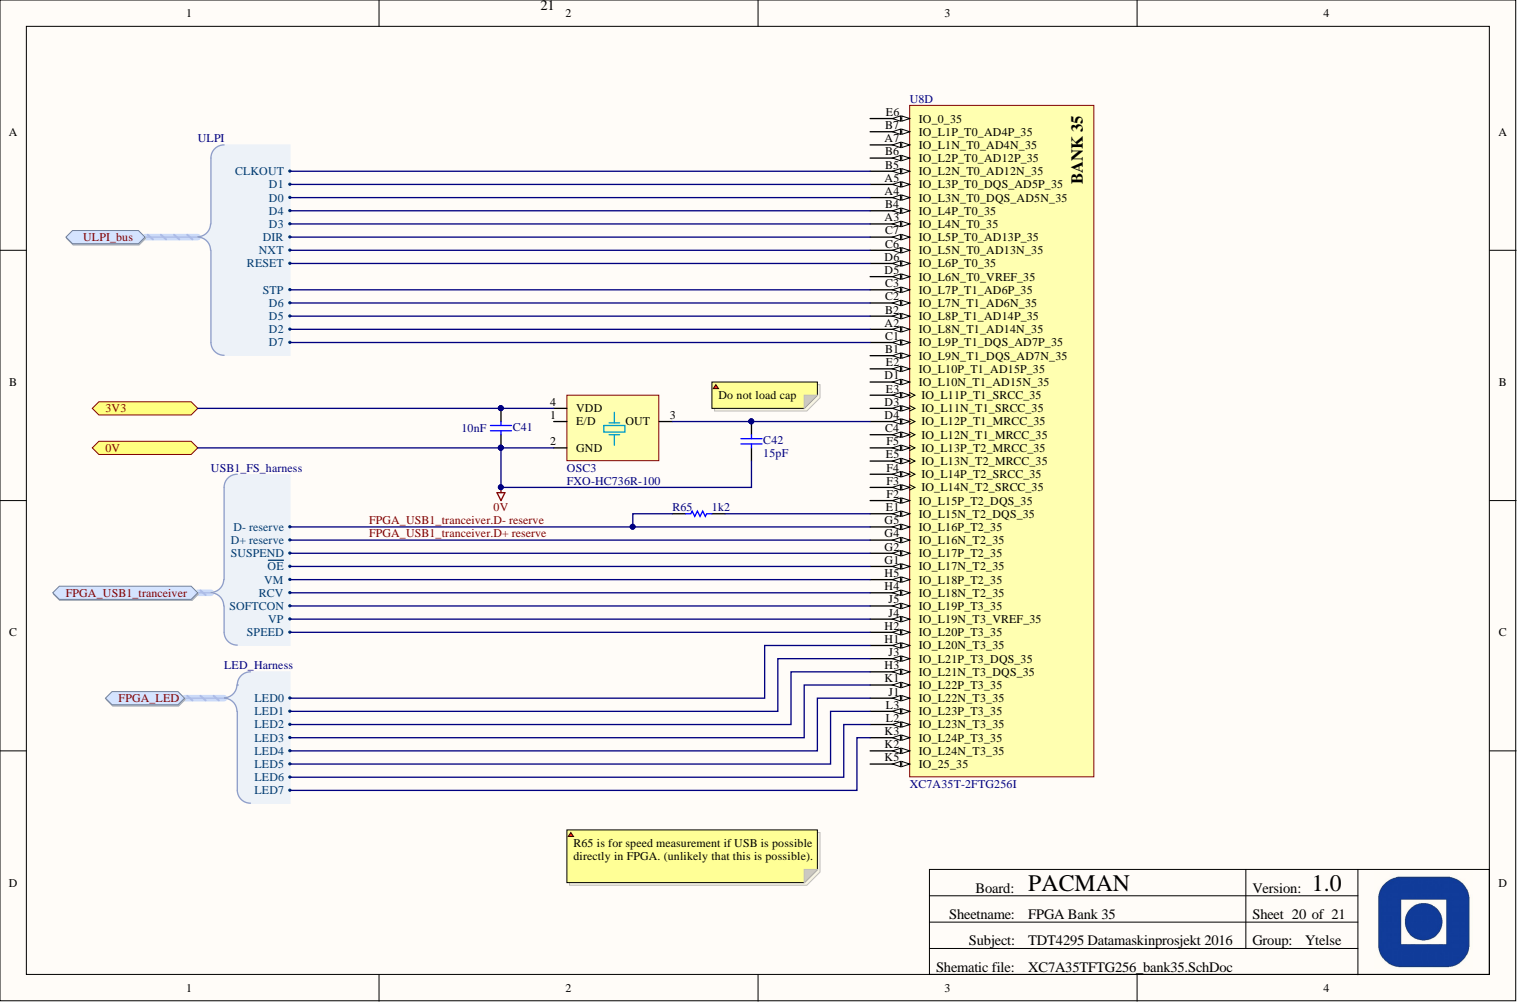
[picture p20: page 20]

Do not load cap

IO_L21P_T3_DQS_35 J3
IO_L21N_T3_DQS_35 H3
IO_L22P_T3_35 K1
IO_L22N_T3_35 J1
IO_L23P_T3_35 L3
IO_L23N_T3_35 L2
IO_L24P_T3_35 K3
IO_L24N_T3_35 K2
IO_25_35 K5

R65 is for speed measurement if USB is possible
directly in FPGA. (unlikely that this is possible).

Board: PACMAN | Version: 1.0

Sheetname: FPGA Bank 35 | Sheet 20 of 21

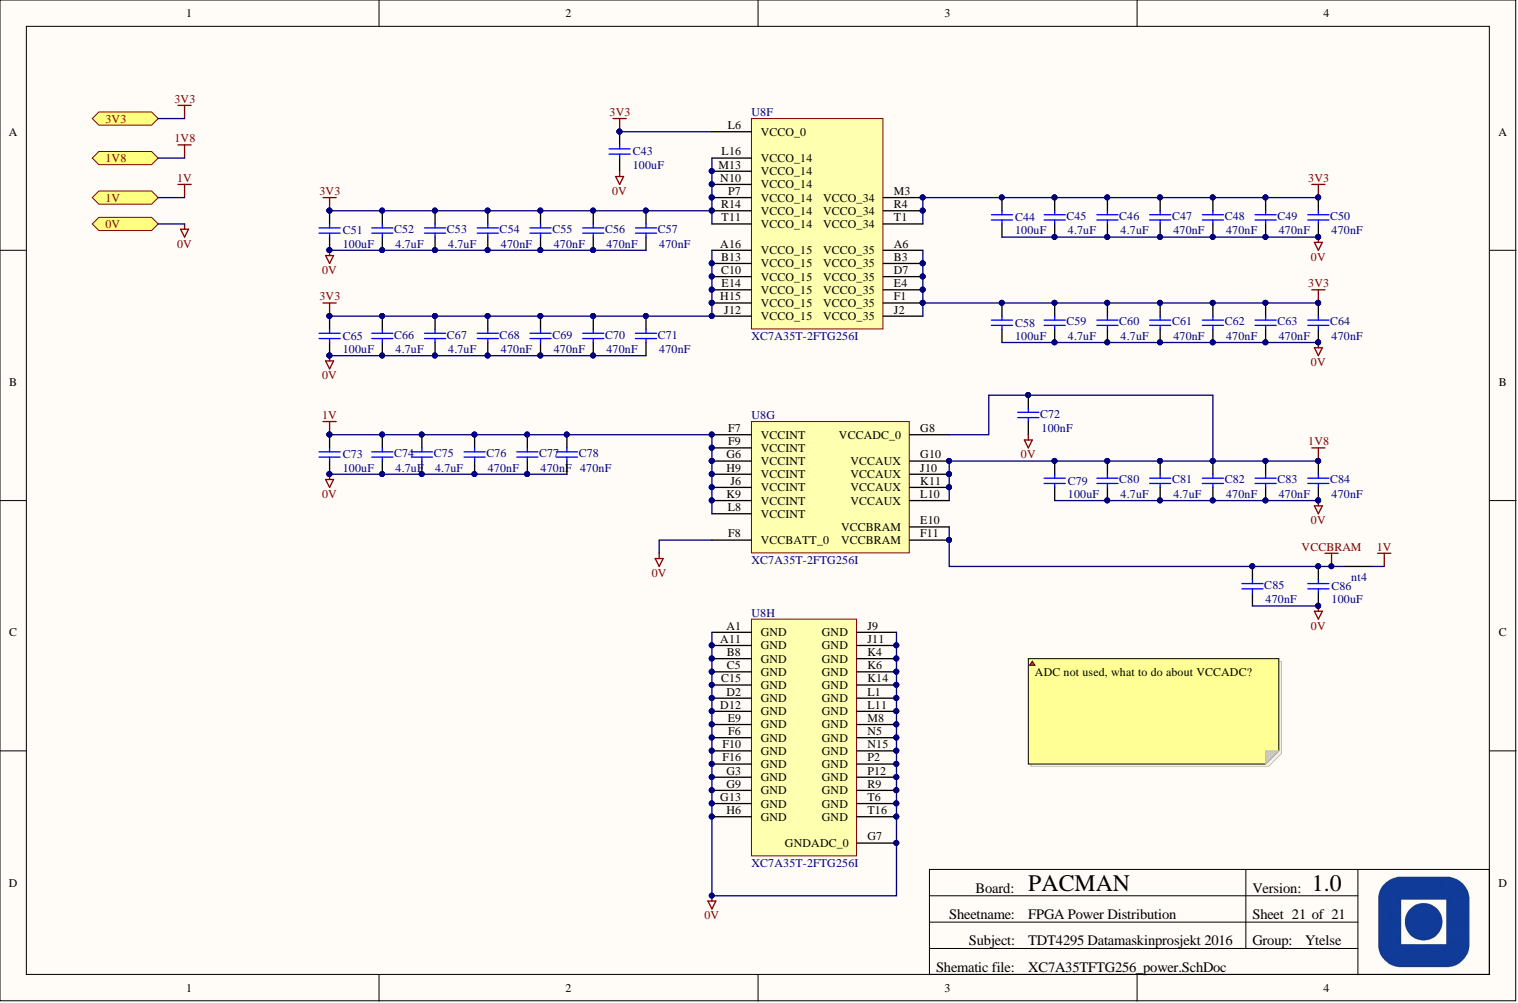
[picture p21: page 21]

ADC not used, what to do about VCCADC?

Board: PACMAN | Version: 1.0

Sheetname: FPGA Power Distribution | Sheet 21 of 21
