Ytelse/pcb/(threads)

Thread 1 (2016-09-16):

Discussion: Powerregulation as part of FPGA subsystem or as separate subsystem at top level?

kringle, 2016-09-16:
Should the power regulation subsystem be part of the FPGA subsystem or as a separate stand-alone subsystem represented at the top level of the schematic?

Alt1: Power as subsystem of FPGA
Pros: System requirements are heavily linked to the FPGA, makes sense to include it with the FPGA.
Cons: Either the FPGA subsystem must output a 3V3 voltage for the EFM, or a second power solution must be considered for that part. Makes little sense either way?

Alt2: Power as separate subsystem at top-level
Pros: Enables use of one centralized power block, which is probably preferrable.
Cons: Looser link to the FPGA. Powering the EFM and other circuits from the same supply as the FPGA makes the supply potentially more noisy. Care must be taken.

Consult with resources at school?

kringle, 2016-09-16:
Since the SD card also needs 3V3, it makes more sense to me at least to put everything in one 3V3 domain and make the power regulation a separate top-level subsystem.

kringle, 2016-09-26:
The power regulation has been moved to the top level.

Closed 2016-09-26.

Thread 2 (2016-09-17):

Separate 3V3 supply for SD-card?

kringle, 2016-09-17:
Since SD-cards might pull a lot of current during write, it might disturb the FPGA. It might be sufficient to use some extra bypass-capacitors?

kringle, 2016-09-26:
Dont think it will be a problem since we are using linear regulators

Closed 2016-09-26.

Thread 3 (2016-09-26):

Missing pull-up (and optional capacitor) on the RESETn pin on the mcu

kringle, 2016-09-26:

kringle, 2016-09-26:
Not fixed yet

kringle, 2016-09-27:
Internal to the MCU, not needed

Closed 2016-09-27.

Thread 5 (2016-09-26):

Missing easily accessable measuring points for all voltage domains

kringle, 2016-09-26:
Need to add 4 x 1-pin connectors ( or 4-pin for all levels in one; 3.3, 1.8, 1.0 and 0V ).

kringle, 2016-09-26:
Not fixed yet

Closed 2016-09-27.

Thread 7 (2016-09-26):

Add diodes to USB.2 Hs bus

seel93, 2016-09-26:

kringle, 2016-09-26:
Not fixed yet

Closed 2016-09-27.

Thread 8 (2016-09-26):

connectors for USB(x4) and power. pluss srcew terminal for 2-3 amper(max 5)

seel93, 2016-09-26:

seel93, 2016-09-26:
two inputs for the screw terminal (+ and -)

seel93, 2016-09-26:
skal det lages ett nytt sheet-entry for connectorene?

seel93, 2016-09-26:
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
sånn her for eksempel

seel93, 2016-09-26:
legger inn transceiver sheet-entry og sheet for transceiverne

seel93, 2016-09-26:
runder av for nå, ser videre på det i morgen

Closed 2016-09-26.

Thread 11 (2016-09-27):

Add uart and tranceiver

kringle, 2016-09-27:

kringle, 2016-09-28:
Easier to use FTDI chip (as mentioned in another Issue), therefore closing this issue.

Closed 2016-09-28.

Thread 15 (2016-09-27):

Maybe use an FT232 dongle instead of RS232

kringle, 2016-09-27:

kringle, 2016-09-27:
UART-USB chip: http://www.ftdichip.com/Support/Documents/DataSheets/ICs/DS_FT232R.pdf, even available on Vault. Can be viable alternative to USB-RS232

seel93, 2016-09-28:
Dette kan eventuelt avklares med gunnar på neste møte. Kan se på hvordan den implementeres slik at det går fort å endre, dersom denne komponenten er mer optimal.

kringle, 2016-09-28:
Joa, men det som er greia er at dersom me bruker RS232 må me ha et adapter fra rs232 til USB, altså typisk en FT232. Så, enten blir linken: UART->RS232->eksternRS232tilUSB->USB, eller så blir den UART->USB. FT232 er heller ikkje vanskelig eller tidkrevende å koble opp, så det er minst like enkelt samt at man får det direkte på vanlig USB med en velprøvd driver. Mange fordeler...

seel93, 2016-09-30:
CBUS3: Configurable CBUS I/O Pin. Function of this pin is configured in the
device internal EEPROM. Factory default configuration is PWREN#. See
CBUS Signal Options, Table 3.99. PWREN# should be used with a 10kΩ
resistor pull up.

seel93, 2016-09-30:
check if pull down resistor needs 5V or 3V3, and if the UART can run on 3V3

Thread 19 (2016-09-30):

Increase footprint size too low dencety for capacitors and resistors

seel93, 2016-09-30:

Thread 21 (2016-10-01):

Is the footprint of the voltage regulator correct?

kringle, 2016-10-01:
It almost looks like it is the mini pack instead of the regular one.

kringle, 2016-10-02:
Not correct. Fixed now.

Closed 2016-10-02.

Thread 24 (2016-10-04):

Thermal bridge on Linear regulators too small

kringle, 2016-10-04:

Closed 2016-10-04.
