Ytelse/pcb/(list of files, drawings)

Other design files:
DMPro16/Connectors.SchDoc
DMPro16/DMPro16.PrjPcb
DMPro16/dmpro16lib.PcbLib
DMPro16/dmpro16lib.SchLib
DMPro16/EFM32_clock.SchDoc
DMPro16/EFM32_IO.SchDoc
DMPro16/EFM32_power.SchDoc
DMPro16/EFM32A.SchDoc
DMPro16/LED.SchDoc
DMPro16/main.SchDoc
DMPro16/MCUtop.SchDoc
DMPro16/N25Q128A13ESE40.SchDoc
DMPro16/pcb.PcbDoc
DMPro16/Power.SchDoc
DMPro16/SDtop.SchDoc
DMPro16/Tranciever_TOP.SchDoc
DMPro16/UART_connect.SchDoc
DMPro16/USB3300.SchDoc
DMPro16/USB_trans.SchDoc
DMPro16/XC7A35TFTG256.SchDoc
DMPro16/XC7A35TFTG256_bank0.SchDoc
DMPro16/XC7A35TFTG256_bank14.SchDoc
DMPro16/XC7A35TFTG256_bank15.SchDoc
DMPro16/XC7A35TFTG256_bank34.SchDoc
DMPro16/XC7A35TFTG256_bank35.SchDoc
DMPro16/XC7A35TFTG256_config.SchDoc
DMPro16/XC7A35TFTG256_IO.SchDoc
DMPro16/XC7A35TFTG256_power.SchDoc
