Ytelse/pcb/(commit log)

2016-09-14 inital commit, added project and main schematic file
    [DMPro16.PrjPcb, main.SchDoc]
2016-09-14 added pcb file and updated project file
    [DMPro16.PrjPcb, pcb.PcbDoc]
2016-09-14 FPGA, MCU og SD
    [DMPro16.PrjPcb, FPGAtop.SchDoc, MCUtop.SchDoc, SDtop.SchDoc, main.SchDoc]
2016-09-16 added four blocks ( possible rough division of system ) to the fpga subsystem. Arrangement non-ideal. Must consider all necessary interfaces
    [FPGAtop.SchDoc]
2016-09-16 outlined main interfaces and rough structure of FPGA subsystem. Included most interfaces and power levels, but no busses or harnesses are formally defined in Altium. Preliminary structure only uses s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
    [FPGAtop.SchDoc]
2016-09-16 added control mcu control logic as interface
    [FPGAtop.SchDoc]
2016-09-16 added interface overview to FPGA subsystem in top level. Added interface overview to SD-card on top level.
    [FPGAtop.SchDoc, main.SchDoc]
2016-09-16 changed format of top level sheet to A4. Might be necessary to resize later, but not necessary now.
    [main.SchDoc]
2016-09-17 added power as separate top-level entity, can be moved again if deemed necessary
    [DMPro16.PrjPcb, FPGAtop.SchDoc, Power.SchDoc, main.SchDoc]
2016-09-17 added FPGA schematic for XC7A35TFTG265
    [DMPro16.PrjPcb, FPGAtop.SchDoc, XC7A35TFTG256.SchDoc]
2016-09-17 added fpga subsheet, compiled
    [FPGAtop.SchDoc, XC7A35TFTG256.SchDoc]
2016-09-17 added subsheets for FPGA sheet (35T-2FTG256 version)
    [Bank14.SchDoc, DMPro16.PrjPcb, XC7A35TFTG256.SchDoc, XC7A35TFTG256_bank14.SchDoc, XC7A35TFTG256_bank15.SchDoc, XC7A35TFTG256_bank34.SchDoc, XC7A35TFTG256_bank35.SchDoc, XC7A35TFTG256_config.SchDoc]
2016-09-17 changed size and arrangement of blocks in xc7a35[..] top sheet. Synchronized ports to propagate interface
    [XC7A35TFTG256.SchDoc]
2016-09-17 removed unused BANK14 file
    [Bank14.SchDoc]
2016-09-17 modified power sheet. Will try to move subsheets from FPGA_top into top sheet to reduce number of levels in the hierarchy
    [FPGAtop.SchDoc, XC7A35TFTG256_power.SchDoc]
2016-09-17 removed FPGAtop sheet from project, restructured so that the XC7A35[...] sheet takes the place of the FPGAtop sheet. Done because it is seemingly not necessary to keep another layer of abstraction be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
    [DMPro16.PrjPcb, FPGAtop.SchDoc, XC7A35TFTG256.SchDoc, main.SchDoc]
2016-09-17 moved power inputs around and routed towards power-supply in XC7 top sheet. Moved the config block around, no other changes in this schematic
    [XC7A35TFTG256.SchDoc, XC7A35TFTG256_config.SchDoc]
2016-09-17 synchronized power sheet with power block in XC7 top sheet
    [XC7A35TFTG256_power.SchDoc]
2016-09-17 slightly rearranged position of components in config and XC7 top sheet
    [XC7A35TFTG256.SchDoc, XC7A35TFTG256_config.SchDoc]
2016-09-17 moved bank14 a bit around. No significant changes
    [XC7A35TFTG256_bank14.SchDoc]
2016-09-17 added config memory subsheet with N25Q128A flash memory
    [DMPro16.PrjPcb, N25Q128A13ESE40.SchDoc, main.SchDoc]
2016-09-17 added notes about wires that will be changed to buses or harnesses in main sheet
    [main.SchDoc]
2016-09-18 wired the config memory sheet, added qspi harness to alle relevant files
    [DMPro16.PrjPcb, N25Q128A13ESE40.SchDoc, XC7A35TFTG256.SchDoc, main.SchDoc]
2016-09-18 removed note about coming harness on QSPI port in main file
    [main.SchDoc]
2016-09-18 added voltage level comments to power schematic for FPGA
    [XC7A35TFTG256_power.SchDoc]
2016-09-18 added comment regarding pul-up on CS line for config memory
    [N25Q128A13ESE40.SchDoc]
2016-09-18 added comment about adding jumpers for easy debugging/signal access
    [N25Q128A13ESE40.SchDoc]
2016-09-18 changed harnesstype for QSPI to QSPI harness
    [XC7A35TFTG256.SchDoc, main.SchDoc]
2016-09-19 Added subsheets to the MCU_top
    Added subsheets power and IO for MCU as well as the overall components
    Added capacitors to the EFM32_power file
    [DMPro16.PrjPcb]
2016-09-19 finalized the components for the EFM32 power sheet
    [DMPro16.PrjPcb]
2016-09-20 Replaced referenced files with local files, project should be non-empty
    [DMPro16.PrjPcb, EFM32A.SchDoc, EFM32_IO.SchDoc, EFM32_power.SchDoc, MCUtop.SchDoc, main.SchDoc]
2016-09-20 Added some notes to the IO sheet
    [EFM32_IO.SchDoc]
2016-09-20 Added an additional sheet to display the MCU clock
    [EFM32_clock.SchDoc]
2016-09-20 added sheet symbol
    [EFM32_IO.SchDoc]
2016-09-20 setup design for high and low frequency clock
    [EFM32_clock.SchDoc]
2016-09-20 Added most of routing necessary for USB3300 tranceiver. Missing oscillator part. Added Harnesses. Not added to project.
    [USB3300.SchDoc]
2016-09-20 added USB3300 subsheet to project, updated interface in top level. Still missing oscillator bit in USB3300 sheet
    [DMPro16.PrjPcb, N25Q128A13ESE40.SchDoc, USB3300.SchDoc, XC7A35TFTG256.SchDoc, main.SchDoc]
2016-09-20 minor changes to USB3300 and schdocPreview
    [USB3300.SchDoc]
2016-09-20 added local library to project to hold self-defined components. Added 100Mhz clock generator as first item. Added 3d model to existing footprint and verified that the footprint and pinout matches the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
    [DMPro16.PrjPcb, USB3300.SchDoc, dmpro16lib.PcbLib, dmpro16lib.SchLib]
2016-09-20 moved VCC pin on oscillator schematic. Added oscillator to USB3300 sheet. Sheet gets a bit crowded, Should look for alternative setups.
    [USB3300.SchDoc, dmpro16lib.SchLib]
2016-09-21 added 48MHz clock generator in library
    [EFM32_IO.SchDoc, dmpro16lib.SchLib]
2016-09-21 added oscilator and harneses
    [EFM32_IO.SchDoc]
2016-09-21 connected IO pins to USB harnes
    [EFM32_IO.SchDoc]
2016-09-21 La til enteries i USB harnes
    [EFM32_IO.SchDoc]
2016-09-21 Lagt til USB_VBUS
    Forsøk på å rydde litt i EFM32_IO
    [EFM32_IO.SchDoc]
2016-09-21 La til HFCLK og fjernet feil i USB
    [EFM32_IO.SchDoc]
2016-09-21 Koblet til UART Harness til riktige pinner
    [EFM32_IO.SchDoc]
2016-09-21 La til Decouple i EFM_IO
    [EFM32_IO.SchDoc]
2016-09-21 added differential pair directive to USB2.0 HS data pair. Moved symbols slightly to improve readability, and added a large comment field on the bottom of the usb3300 sheet to hold important notes
    [USB3300.SchDoc]
2016-09-21 added simple outputjob for generating schematic prints
    [DMPro16.PrjPcb]
2016-09-21 changed to colored schematic output
2016-09-21 changed numbering of all sheets so that sheets are presented in logical order when PDF is generated
    [EFM32_IO.SchDoc, EFM32_power.SchDoc, MCUtop.SchDoc, N25Q128A13ESE40.SchDoc, Power.SchDoc, SDtop.SchDoc, USB3300.SchDoc, XC7A35TFTG256.SchDoc]
2016-09-21 generated documentation PDF for schematics to send to Gunnar
2016-09-22 Added oscillator part number as visible in schematic, moved resistor to increase readability
    [USB3300.SchDoc]
2016-09-22 added some comments to power schematic
    [Power.SchDoc]
2016-09-22 La til komponent
    [EFM32_IO.SchDoc, EFM32_power.SchDoc, MCUtop.SchDoc, dmpro16lib.PcbLib, dmpro16lib.SchLib, main.SchDoc]
2016-09-22 did some wiring on the sd-card sheet
    [SDtop.SchDoc]
2016-09-22 Endret USB harness i EFM
    [DMPro16.PrjPcb, EFM32_IO.SchDoc, EFM32_power.SchDoc, MCUtop.SchDoc]
2016-09-22 Koblet til ESD protectom device i MCU_IO
    [EFM32_IO.SchDoc]
2016-09-22 wired a first suggestion for the power subsystem. Using 3 LÅ38501 linear regulators = much space, but easy implementation
    [DMPro16.PrjPcb, Power.SchDoc]
2016-09-23 removed unnessesary VBUS sheet entry
    [EFM32_IO.SchDoc]
2016-09-23 updated SD card harness
    [SDtop.SchDoc]
2016-09-23 added power to power sheet and to config sheet
    [XC7A35TFTG256.SchDoc, XC7A35TFTG256_config.SchDoc, XC7A35TFTG256_power.SchDoc]
2016-09-23 completed wiring for SD inputs
    [SDtop.SchDoc]
2016-09-23 added harness entries to JTAG harness
    [EFM32_IO.SchDoc]
2016-09-23 added comment to explain pin function
    [XC7A35TFTG256_bank14.SchDoc]
2016-09-23 added JTAG harness to config block
    [XC7A35TFTG256_config.SchDoc]
2016-09-23 La til EBI wires med Lables til EFM_IO
    De er ikke koblet til noen harness enda
    [EFM32_IO.SchDoc]
2016-09-23 added net names to harnesses at top level
    [DMPro16.PrjPcb, main.SchDoc]
2016-09-23 added qspi config bus to config schematic. Moved sheet entry to left side of fpga top sheet because it is ain input to the system
    [XC7A35TFTG256.SchDoc, XC7A35TFTG256_config.SchDoc]
2016-09-23 finalized SD-top design
    write protect wiring is optional, and im not really sure which switch
    that should be used
    [SDtop.SchDoc]
2016-09-23 wired most of the config in bank0. Tried to move bank 14 into config schematic, but it is too small. Either increase to A3, or add extra layer of abstraction
    [XC7A35TFTG256.SchDoc, XC7A35TFTG256_bank14.SchDoc, XC7A35TFTG256_config.SchDoc]
2016-09-23 adding extra layer to fpga by introducing subsheet IO.
    [DMPro16.PrjPcb, XC7A35TFTG256.SchDoc, XC7A35TFTG256_IO.SchDoc]
2016-09-23 moved IO banks to fpga IO sheet and recompiled
    [XC7A35TFTG256.SchDoc, XC7A35TFTG256_IO.SchDoc]
2016-09-23 Added file fpga_bank0 and moved fpga_bank14 to fpga_config subsheet. Recompiled project
    [DMPro16.PrjPcb, XC7A35TFTG256.SchDoc, XC7A35TFTG256_IO.SchDoc, XC7A35TFTG256_bank0.SchDoc, XC7A35TFTG256_config.SchDoc]
2016-09-23 Cleaned up in bank 0, added ports and sheet entries to bank 14
    [XC7A35TFTG256_bank0.SchDoc, XC7A35TFTG256_bank14.SchDoc, XC7A35TFTG256_config.SchDoc]
2016-09-23 add sheet for tranciever
    [DMPro16.PrjPcb, Tranciever_TOP.SchDoc, main.SchDoc]
2016-09-23 added QSPI harness to bank 14 sheet
    [DMPro16.PrjPcb, XC7A35TFTG256_bank14.SchDoc]
2016-09-23 Completed preliminary routing of bank14
    [XC7A35TFTG256_bank14.SchDoc]
2016-09-23 changed wiring to comform better to ARTY/BASYS3 design. Removed indicator led in INIT signal, since this is not implemented in either reference design
    [XC7A35TFTG256_bank0.SchDoc]
2016-09-23 added pull-ups to W# and HOLD# on the config flash, in accordance with the schematics on the ARTY and BASYS 3 boards
    [N25Q128A13ESE40.SchDoc]
2016-09-23 added mid-level port connectors etc for config part of FPGA
    [XC7A35TFTG256_bank0.SchDoc, XC7A35TFTG256_config.SchDoc]
2016-09-23 added jtag connection to fpga top level
    [XC7A35TFTG256.SchDoc]
2016-09-23 added standard cap symbol to dmpro library. Added 1210 capacitor model to dmpro library
    [dmpro16lib.PcbLib, dmpro16lib.SchLib]
2016-09-23 added 100uF xilinx recommended capacitor to library
    [dmpro16lib.SchLib]
2016-09-23 small adjustments to schematic models in library
    [dmpro16lib.SchLib]
2016-09-23 Preliminary wiring for power decoupling network done
    [XC7A35TFTG256_power.SchDoc, dmpro16lib.SchLib]
2016-09-23 added comment about VCCadc and VCCbat
    [XC7A35TFTG256_power.SchDoc]
2016-09-23 wired VCCbat to 0V as directed in UG475, changed comment about ADCVCC and VCCBAT
    [XC7A35TFTG256_power.SchDoc]
2016-09-23 Severe cleanup in FPGA top level.
    [XC7A35TFTG256.SchDoc]
2016-09-23 Moved top level blocks around, need more cleanup but ok for now
    [main.SchDoc]
2016-09-23 added sheet entry ports to fpga IO midlevel
    [XC7A35TFTG256_IO.SchDoc]
2016-09-23 Allocated the various buses to dedicated io banks
    [XC7A35TFTG256_IO.SchDoc]
2016-09-23 updated ports on top level to be harness entries. Added FPGA_UBS1 sheet entry in fpga top level
    [XC7A35TFTG256.SchDoc, main.SchDoc]
2016-09-23 added FPGA_USB harness in fpga io subsheet
    [XC7A35TFTG256_IO.SchDoc]
2016-09-23 added SD harness to bank 34 in FPGA io section
    [DMPro16.PrjPcb, XC7A35TFTG256_bank34.SchDoc]
2016-09-23 wired SD card interface to random pins in bank 34
    [XC7A35TFTG256_bank34.SchDoc]
2016-09-23 added sheet entry to bank 15
    [XC7A35TFTG256_bank15.SchDoc]
2016-09-23 added ULPI and usb harness and schematic sheet entry to bank 35
    [DMPro16.PrjPcb, XC7A35TFTG256_bank35.SchDoc]
2016-09-24 Fjernet unødvendig ports på MCUtop
    Fjernet USB_VBUS port som gikk fra EFM_power til EFM_IO
    I tillegg til en unødvedig kommentar i EFM_power
    [EFM32_power.SchDoc, MCUtop.SchDoc]
2016-09-24 Connected ULPI lines to FPGA bank 35
    [XC7A35TFTG256_bank35.SchDoc]
2016-09-24 removed mcu transceiver
    [DMPro16.PrjPcb, EFM32_IO.SchDoc, main.SchDoc]
2016-09-24 added header for ULPI on the USB sheet
    [USB3300.SchDoc]
2016-09-24 added headers to the USB on the USB sheet
    [USB3300.SchDoc]
2016-09-24 La til header for Serial Wire Debug i EFM
    [EFM32_IO.SchDoc]
2016-09-24 Lagt til reset button i EFM_IO
    [EFM32_IO.SchDoc]
2016-09-24 added header for the sd-card
    [SDtop.SchDoc]
2016-09-24 changed the number of pins on the header
    [SDtop.SchDoc]
2016-09-24 added power sequencing to power supply
    [Power.SchDoc]
2016-09-24 changed the header on for USB2
    [USB3300.SchDoc]
2016-09-24 added headers
    [N25Q128A13ESE40.SchDoc]
2016-09-24 added mode configurator switch and reconfigure button to bank 0
    [XC7A35TFTG256_bank0.SchDoc]
2016-09-24 Koblet EBI pins til en bus
    [EFM32_IO.SchDoc]
2016-09-24 added LED sheet
    [DMPro16.PrjPcb, LED.SchDoc, main.SchDoc]
2016-09-24 Modified power sequence to be VCCINT->VCCAUX->VCCO, as per the data sheet
    [Power.SchDoc]
2016-09-24 connected CFGBVS to 3V3
    [XC7A35TFTG256_bank0.SchDoc]
2016-09-24 removed comment about the MODE pins
    [XC7A35TFTG256_bank0.SchDoc]
2016-09-24 added comment about led and pull-up on DONE_0 pin
    [XC7A35TFTG256_bank0.SchDoc]
2016-09-24 Koblet til EBI buss til harness
    [EFM32_IO.SchDoc]
2016-09-24 added LED for mcu
    [DMPro16.PrjPcb, LED.SchDoc]
2016-09-24 added sheet-entry for MCU-LED
    [main.SchDoc]
2016-09-24 finished MCU-Leds
    [LED.SchDoc]
2016-09-24 added pullups to JTAG pins on the FPGA, connected VCCADC to VCCAUX
    [XC7A35TFTG256_bank0.SchDoc, XC7A35TFTG256_power.SchDoc]
2016-09-24 Koblet EBI harnessen til EBI port
    [EFM32_IO.SchDoc]
2016-09-24 Set VP and VN to 0V as per schematic review recommendation
    [XC7A35TFTG256_bank0.SchDoc]
2016-09-24 La til LEDs i EFM_IO
    [EFM32_IO.SchDoc]
2016-09-24 added clock to bank 35
    [XC7A35TFTG256_bank35.SchDoc]
2016-09-24 set DXP_0 and DXN_0 to zero
    [XC7A35TFTG256_bank0.SchDoc]
2016-09-24 removed JTAG harness from bank0, will insert JTAG connector directly in sheet.
    [XC7A35TFTG256_bank0.SchDoc]
2016-09-24 La til MCU_CTRL_LOGIC og byttet LED pins
    [EFM32_IO.SchDoc]
2016-09-24 added 14 pin 2mm pitch connector for Xilinx JTAG header to library.
    [dmpro16lib.PcbLib, dmpro16lib.SchLib]
2016-09-24 Added JTAG connector to bank 0 sheet
    [XC7A35TFTG256_bank0.SchDoc]
2016-09-24 removed all JTAG sheet entries and connectors for FPGA and MCU.
    [EFM32_IO.SchDoc, MCUtop.SchDoc, XC7A35TFTG256.SchDoc, XC7A35TFTG256_config.SchDoc, main.SchDoc]
2016-09-24 switched SD card wire for harness
    [main.SchDoc]
2016-09-24 Added comment aobut the possibility of changing 2mm JTAG header for 2.54 mm standard header to have increased flexibility
    [XC7A35TFTG256_bank0.SchDoc]
2016-09-24 Updated sheet numbering for all sheets, and generated new pdf of schematics
    [EFM32_IO.SchDoc, EFM32_power.SchDoc, LED.SchDoc, MCUtop.SchDoc, N25Q128A13ESE40.SchDoc, Power.SchDoc, SDtop.SchDoc, USB3300.SchDoc]
2016-09-25 Setup project to generate structure classes. Auto-annotated all components in the project
    [DMPro16.PrjPcb, EFM32_IO.SchDoc, EFM32_power.SchDoc, LED.SchDoc, N25Q128A13ESE40.SchDoc, Power.SchDoc, SDtop.SchDoc, USB3300.SchDoc]
2016-09-25 Restructured main, added power connectors to every sheet entry.
    [main.SchDoc]
2016-09-25 renamed qspi-bus to Config_QSPI due to compilation error over multiple names
    [N25Q128A13ESE40.SchDoc, XC7A35TFTG256.SchDoc, XC7A35TFTG256_bank0.SchDoc, XC7A35TFTG256_bank14.SchDoc, XC7A35TFTG256_config.SchDoc, main.SchDoc]
2016-09-25 renamed ULPI_bus due to compilation error
    [USB3300.SchDoc, XC7A35TFTG256.SchDoc, XC7A35TFTG256_IO.SchDoc, XC7A35TFTG256_bank35.SchDoc, main.SchDoc]
2016-09-25 renamed MCU_USB harness due to compiler errors
    [DMPro16.PrjPcb, EFM32_IO.SchDoc, EFM32_power.SchDoc, MCUtop.SchDoc, main.SchDoc]
2016-09-25 removed vault revision mismatch compilation error from project files
    [DMPro16.PrjPcb]
2016-09-25 rewired a component that had been disconnected from its correct net. Added comment about correct voltage on REG_EN pin on USB3300
    [USB3300.SchDoc]
2016-09-25 changed net-name on pins connected to EBI harness connector on MCU IO sheet. Added comment about this in the sheet. Changed EBI sheet entry at MCU top level to harness
    [EFM32_IO.SchDoc, MCUtop.SchDoc]
2016-09-25 changed MCU_CTRL_LOGIC to harness in mian and mcu_top sheets
    [MCUtop.SchDoc, main.SchDoc]
2016-09-25 changed LED harness definition, added harnesses along the route from MCU to LED sheet. Added 0V port to LED sheet for connectivity
    [EFM32_IO.SchDoc, LED.SchDoc, MCUtop.SchDoc, main.SchDoc]
2016-09-25 added LED connections all the way to the FPGA, renaming and adding harnesses as appropriate
    [LED.SchDoc, XC7A35TFTG256.SchDoc, XC7A35TFTG256_IO.SchDoc, XC7A35TFTG256_bank35.SchDoc, main.SchDoc]
2016-09-25 removed last pieces of the UART wiring. We will attempt to not use it
    [EFM32_IO.SchDoc, MCUtop.SchDoc]
2016-09-25 moved harness connector to establish proper contact. Strange compilation error that disappeared after doing this.
    [LED.SchDoc, main.SchDoc]
2016-09-25 changed harness definitons to avoid conflicitng harness definition errors
    [EFM32_IO.SchDoc, LED.SchDoc]
2016-09-25 Previous error in harness definition persisted an was caused by mixing 1-indexing and 0-indexing for LED numbering. Have set all indexing to 0-indexing
    [LED.SchDoc, XC7A35TFTG256_bank35.SchDoc]
2016-09-25 added noERC marker to ID pin on USB3300
    [USB3300.SchDoc]
2016-09-25 Fixed issue where entries in EBI harness was marked as LED_harnesses. Fixed issue with naming in EFM_IO sheet by renaming to A[x..xDy] and B[x..y] in stead of the previously used EBI.A[x...y] which c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
    [EFM32_IO.SchDoc]
2016-09-25 finally figured out the correct way to approach naming with buses and harnesses. Current implementation doesnt seem to create any compilation errors, and is logically sound
    [DMPro16.PrjPcb, EFM32_IO.SchDoc, XC7A35TFTG256_bank15.SchDoc]
2016-09-25 added MCU_CTRL_LOGIC harness to bank 15. Renamed signals to B[0..9]. Need to rename in MCU_IO as well
    [EFM32_IO.SchDoc, MCUtop.SchDoc, XC7A35TFTG256_bank15.SchDoc]
2016-09-25 renamed MCU_CTRL_LOGIC bus to MCU_BRIDGE bus for clarity. Maybe worse, but at least a better name
    [EFM32_IO.SchDoc, MCUtop.SchDoc, XC7A35TFTG256.SchDoc, XC7A35TFTG256_IO.SchDoc, XC7A35TFTG256_bank15.SchDoc, main.SchDoc]
2016-09-25 added noERC markers to several pins in the power sheet. Done to remove errors that have been checked and verified
    [Power.SchDoc]
2016-09-25 added 3V3 to top level in MCU sheet and connectors down into MCU_IO sheet. Needed 3V3 for Oscillator
    [EFM32_IO.SchDoc, MCUtop.SchDoc]
2016-09-25 renamed control pins on EBI bus
    [EFM32_IO.SchDoc]
2016-09-25 added power entries to power sheet on MCU_power sheet. Changed name to 3V3 and 0V on all power nets
    [EFM32_IO.SchDoc, EFM32_power.SchDoc, N25Q128A13ESE40.SchDoc, XC7A35TFTG256_config.SchDoc]
2016-09-25 added 3V3 and 0V sheet entries to IO banks top sheet
    [EFM32_IO.SchDoc, SDtop.SchDoc, XC7A35TFTG256_IO.SchDoc, XC7A35TFTG256_bank35.SchDoc]
2016-09-25 added stricter warnings on selected errors to ERC checker
    [DMPro16.PrjPcb]
2016-09-25 Generated updated schematic documentation
2016-09-26 added a project variable as a test.
    [DMPro16.PrjPcb]
2016-09-26 started adding an A4 schematic template, not completed
2016-09-26 completed first suggestion for schematic template.
2016-09-26 changed snap grid to 2.54 mm
2016-09-26 set template on bank 35
    [XC7A35TFTG256_bank35.SchDoc]
2016-09-26 added all project parameters to project
    [DMPro16.PrjPcb]
2016-09-26 Changed variable name of Subject to TDT4295 Datamaskinprosjekt
    [DMPro16.PrjPcb]
2016-09-26 Did some changes
    [LED.SchDoc]
2016-09-26 added new template to all files, added Sheetname to all sheets.
    [EFM32_IO.SchDoc, EFM32_power.SchDoc, LED.SchDoc, MCUtop.SchDoc, N25Q128A13ESE40.SchDoc, Power.SchDoc, SDtop.SchDoc, USB3300.SchDoc]
2016-09-26 added net labels to JTAG pins on FPGA
    [XC7A35TFTG256_bank0.SchDoc]
2016-09-26 changed force config button for fpga to the same one used in the mcu reset circuit
    [XC7A35TFTG256_bank0.SchDoc]
2016-09-26 added connectors for usb in a sheet-entry
    USB_connect sheet contains all the connectors as well as the harnesess for
    the different components
    [DMPro16.PrjPcb, USB_connect.SchDoc, main.SchDoc]
2016-09-26 removed USB UART from the main and Conect sheet
    [USB_connect.SchDoc, main.SchDoc]
2016-09-26 added component to the transceiver sheet
    [DMPro16.PrjPcb, USB_trans.SchDoc, main.SchDoc]
2016-09-26 Applied schematic template to tranciever subsheet, added sheetname parameter
    [USB_trans.SchDoc]
2016-09-26 Switched the inserted tranceiver for TUSB2551 for the full-speed tranceiver. Not necessary with another High speed tranceiver
    [USB_trans.SchDoc]
2016-09-26 wired up a TSUB2551APW USB 1.1 tranceiver and annotated the components. Added a harness for the USB1 signals to the FPGA
    [DMPro16.PrjPcb, USB_trans.SchDoc]
2016-09-26 added USB harness to usb_trans sheet. This sheet should be ok now.
    [USB_trans.SchDoc]
2016-09-26 added sheet port for USB1 tranceiver control bus
    [USB_trans.SchDoc]
2016-09-26 cleaned up main (again), and added appropriate harnesses on all blocks. Removed sheet entry for UART
    [main.SchDoc]
2016-09-26 removed redundant USB2_HS harness, replaced with usb harness used elsewhere in project
    [USB3300.SchDoc]
2016-09-26 changed sheet entry to USB harness type on both connector and USB3300 sheet symbol
    [USB3300.SchDoc, main.SchDoc]
2016-09-26 added USB1_FS_harness to bank 35, and changed harness type all the way through the hierarchy
    [XC7A35TFTG256.SchDoc, XC7A35TFTG256_IO.SchDoc, XC7A35TFTG256_bank35.SchDoc]
2016-09-26 added wiring for USB 1.1 bus and resistor for doing speed measurement. Confindence that this is actually going to work = 0, but not necessary to load if not used
    [XC7A35TFTG256_bank35.SchDoc]
2016-09-26 annotated schematics, only bank 35
    [DMPro16.PrjPcb]
2016-09-26 renamed usb connectors sheet to the more general connectors
    [Connectors.SchDoc, DMPro16.PrjPcb, main.SchDoc]
2016-09-26 removed usb_connect sheet which is not needed any more
    [USB_connect.SchDoc]
2016-09-26 moved reference in main sheet from usb connectors to connectors
    [main.SchDoc]
2016-09-26 added connectors and wired them to their respective harnesses
    [Connectors.SchDoc, DMPro16.PrjPcb]
2016-09-26 annotated schematics
    [DMPro16.PrjPcb]
2016-09-26 added jumper resistors on VBUS and GND connections to provide possibility to disconnect if necessary
    [Connectors.SchDoc]
2016-09-26 added terminal block for extra 5V connection
    [Connectors.SchDoc]
2016-09-26 added power good led to 5V line
    [Power.SchDoc]
2016-09-26 added buffer to LED sheet, to be certain that it is possible to deliver the current to the leds.
    [LED.SchDoc]
2016-09-26 annotated new components in led sheet
    [LED.SchDoc]
2016-09-26 Applied schematic template to connector sheet. Added sheetname to document
    [Connectors.SchDoc]
2016-09-26 added 3V3 sheet entry on LED in main sheet
    [main.SchDoc]
2016-09-26 removed template from project to avoid conflicting top sheet error. Do not delete from folder!
    [DMPro16.PrjPcb]
2016-09-26 updated sheet number, document number and sheet count
    [Connectors.SchDoc, EFM32_IO.SchDoc, EFM32_power.SchDoc, LED.SchDoc, MCUtop.SchDoc, N25Q128A13ESE40.SchDoc, Power.SchDoc, SDtop.SchDoc]
2016-09-26 changed harness definition for USB. Renamed DM to D_N and DP to D_P. This is done to be able to define the D_P and D_N as differential pairs
    [Connectors.SchDoc, EFM32_IO.SchDoc, EFM32_power.SchDoc, USB3300.SchDoc, USB_trans.SchDoc, main.SchDoc]
2016-09-26 added net tie to library
    [dmpro16lib.PcbLib, dmpro16lib.SchLib]
2016-09-26 added net tie to GND on USB harness
    [USB3300.SchDoc]
2016-09-26 Changed sheet entry to sd_card type harness
    [XC7A35TFTG256.SchDoc, main.SchDoc]
2016-09-26 updated harness net name for USB 1 FS - bus between USB1 tranceiver and FPGA. Lots of unconnected pins because of naming error. Now fixed
    [XC7A35TFTG256.SchDoc, XC7A35TFTG256_IO.SchDoc, XC7A35TFTG256_bank35.SchDoc, main.SchDoc]
2016-09-26 Placed noERC markers on ID pins on connectors, since none of them will be connected
    [Connectors.SchDoc]
2016-09-26 Fixed error where harness was misplaced on one USB connector
    [Connectors.SchDoc]
2016-09-26 Added explicit net names to USB 2.0 HS signals to define as differential pair
    [USB3300.SchDoc]
2016-09-26 flipped oscillator, which was connected wrong to 3V3 and 0V
    [EFM32_IO.SchDoc]
2016-09-26 added net tie and GND connection to USB bus for the EFM
    [EFM32_power.SchDoc]
2016-09-26 removed unneeded sheet entry
    [XC7A35TFTG256_config.SchDoc]
2016-09-26 Added noERC to VBUS + and - for the FPGA USB1 connector
    [Connectors.SchDoc]
2016-09-26 renamed 5V power to 5V_USB
    [Power.SchDoc]
2016-09-26 most critical errors removed, with the exception of an error related to oscillator on MCU, need verification from August. Generated new schematic documents ( using Board name Botty McBotFace )
2016-09-27 Changed to header that does not break the line on the ULPI bus
    [USB3300.SchDoc]
2016-09-27 annotated new header
    [USB3300.SchDoc]
2016-09-27 Byttet ut 10 pin header med 20 pin header i EFM_IO
    [EFM32_IO.SchDoc]
2016-09-27 chenged SD card interface header to 10 pins in stead of 14 pins. Added 3V3 and GND to the header to easily use logic analyzer
    [SDtop.SchDoc]
2016-09-27 discovered error in wiring of SW3, force configure switch. Error would cause pin Program_B_0 to always be connected to ground. Fixed.
    [XC7A35TFTG256_bank0.SchDoc]
2016-09-27 fixed error in connecting of the SW1, reset button on the EFM. Would have cause always 0 reset
    [EFM32_IO.SchDoc]
2016-09-27 annotated programming header
    [EFM32_IO.SchDoc]
2016-09-27 added button and debouncing to use for reset. Annotated
    [XC7A35TFTG256_bank14.SchDoc]
2016-09-27 added, then removed USB protection diode again. Probably more logical to insert in connector sheet
    [USB3300.SchDoc]
2016-09-27 removed usb protection diode from EFM32_IO sheet and moved it to connectors sheet. Added usb protection diodes to all USB connectors
    [Connectors.SchDoc, EFM32_IO.SchDoc]
2016-09-27 removed USB connector
    [EFM32_IO.SchDoc]
2016-09-27 added 4-pin header for voltage measurement
    [Power.SchDoc]
2016-09-27 added 16 pin single row header for emergency connections to FPGA
    [XC7A35TFTG256_bank14.SchDoc]
2016-09-27 added 5-pin header for emergency connections. Might need to add more
    [EFM32_IO.SchDoc]
2016-09-27 Added for-redundancy-only pullup on DQ1 on config memory
    [N25Q128A13ESE40.SchDoc]
2016-09-30 added breakout headers for EBI and mcu control bus
    [DMPro16.PrjPcb, XC7A35TFTG256_bank15.SchDoc]
2016-09-30 added 0V sheet entry to Bank15
    [XC7A35TFTG256_IO.SchDoc]
2016-09-30 added infrastructure for adding FT232 chip. Want to put on-board if possible, but should add header to access UART if something wrong
    [Connectors.SchDoc, MCUtop.SchDoc, main.SchDoc]
2016-09-30 added connector sheet for the FT232
    [DMPro16.PrjPcb, UART_connect.SchDoc, main.SchDoc]
2016-09-30 imported components to pcb
    [pcb.PcbDoc]
2016-09-30 added internal layers for an 8-layer stackup
    [pcb.PcbDoc]
2016-09-30 updated footprints of resistors to low density models, better for soldering
    [N25Q128A13ESE40.SchDoc]
2016-09-30 updated footprint of R75 to low density version
    [N25Q128A13ESE40.SchDoc]
2016-09-30 made some changes to connect- and harnes-sheet
    [DMPro16.PrjPcb]
2016-09-30 removed old comment
    [N25Q128A13ESE40.SchDoc]
2016-09-30 set capacitor footprints to low density
    [USB3300.SchDoc]
2016-09-30 changed pinout for ULPI-bus listener header to get easier routing
    [USB3300.SchDoc]
2016-09-30 moved connectors to left side of board, started routing. Not finished
2016-09-30 added header for UART
    [UART_connect.SchDoc]
2016-09-30 removed buffers from the debug LEDs
    [LED.SchDoc]
2016-09-30 added pull-down resistor for the CBUS3
    [UART_connect.SchDoc]
2016-09-30 Changed layer stackup to three ground layers, one power layer. Moved main blocks of design around to get a rough feeling for the design layout.
2016-09-30 Added nets to ground and power planes
2016-09-30 changed footprint for header in IO-sheet
    [EFM32_IO.SchDoc]
2016-09-30 Koblet UART til EFM_IO
    [EFM32_IO.SchDoc]
2016-09-30 Fixed many small issues related to UART_Connect sheet. Removed room generation from project while trying to figure out what is wrong with net class generation
    [DMPro16.PrjPcb, EFM32_IO.SchDoc, EFM32_power.SchDoc, UART_connect.SchDoc, main.SchDoc]
2016-09-30 removed all rooms from pcb
2016-09-30 finalized UART connector for USB
    [UART_connect.SchDoc]
2016-09-30 fixed issue where two rooms were attempting to have the same name, and some nets where all over the place. Changed name of power part of mcu subsystem, thereby fixing a double naming error.
    [DMPro16.PrjPcb, MCUtop.SchDoc]
2016-09-30 Changed names on rooms for mcu io and power regulators to be more consistent
    [MCUtop.SchDoc, main.SchDoc]
2016-10-01 Endret på posisjon til leds og resistorer i forhold til hverandre
2016-10-01 wired resistors with LEDs for fpga and MCU
    [LED.SchDoc]
2016-10-01 Koblet til led som ikke var koblet til
2016-10-01 Koblet sammen capacitors til EFM_Power
2016-10-01 removed ID pin from USB harness
    [Connectors.SchDoc, EFM32_IO.SchDoc, EFM32_power.SchDoc, UART_connect.SchDoc, USB3300.SchDoc, USB_trans.SchDoc]
2016-10-01 annotated C92 in UART_connect sheet
    [DMPro16.PrjPcb, UART_connect.SchDoc]
2016-10-01 Fixed naming error, where harness sheet entry USB_FT232 was erronously named USB_FT233
    [Connectors.SchDoc]
2016-10-01 started wiring the UART sub connecto
2016-10-01 Endret på plassering av capacitor i EFM_power
    [EFM32_power.SchDoc]
2016-10-01 wiring the UART_USB
    made some changes in the sheet as well to make the wiring more optimal
    [UART_connect.SchDoc]
2016-10-01 added header for MCU leds
    added prject log to .gitignore
    did some wiring on the UART-component on the pcb
    [LED.SchDoc, UART_connect.SchDoc]
2016-10-01 added header for the MCU leds
2016-10-01 changed to bigger footprint on capacitors
    [EFM32_power.SchDoc]
2016-10-01 added net name EFM_RES to reset line on MCU
    [EFM32_IO.SchDoc]
2016-10-01 preliminary wiring of MCU done. Changed design rules: Removed all clearance rules not giving 0.1mm min clearance
2016-10-01 changed C3 to low density footprint. Routed in mcu subcircuit
    [EFM32_IO.SchDoc]
2016-10-01 most of MCU wired up, might have to make this part smaller later. Switched around on pins in header ans MCU IO to get easier routing
    [DMPro16.PrjPcb, EFM32_IO.SchDoc, EFM32_power.SchDoc, XC7A35TFTG256_bank15.SchDoc]
2016-10-01 added net names to extra pins
    [XC7A35TFTG256_bank14.SchDoc]
2016-10-01 added net tie to power sheet to separate 1V for INT and BRAM.
    [XC7A35TFTG256_power.SchDoc]
2016-10-01 Changed size of board and moved fpga and mcu onto it. Starting FPGA<->MCU routing now
2016-10-01 moved pin nets around to make the routing easier for the EBI.A bus. Routing of EBI.A complete
    [XC7A35TFTG256_bank15.SchDoc]
2016-10-01 completed pleliminary wiring of EBI.D, changed pin allocation on FPGA to make routing easier
    [XC7A35TFTG256_bank15.SchDoc]
2016-10-01 completed routing of MCU bridge bus. Very long lines, but but
    [XC7A35TFTG256_bank15.SchDoc]
2016-10-01 preliminary routing of MCU and FPGA is complete. Missing config-stuff and a lot of other sutff. Started routing on power, not completed
2016-10-02 Flipped 5V connector for easier routing
    [Connectors.SchDoc]
2016-10-02 moved regulators closer to FPGA, rerouted power sequencing circuit
2016-10-02 added two 2-pins headers for debugging/testing of power sequencing
    [Power.SchDoc]
2016-10-02 Moved USB3300 onto board
2016-10-02 Routed ULPI bus. Switched around on the harness to get easier routing
    [XC7A35TFTG256_bank35.SchDoc]
2016-10-02 moved 1V8 decoupling to left side of FPGA to have shorter wires to supply
2016-10-02 added headers to USB1.1 tranceiver control lines for debugging. Switched round on the harness to get easier routing
    [USB_trans.SchDoc, XC7A35TFTG256_bank35.SchDoc]
2016-10-02 added differnetial pair directive to USB1.1 signal pair
    [USB_trans.SchDoc]
2016-10-02 moved components around to figure out where to position. SD card is a challenge. At the moment positioned under one of the regulators. Could become problem due to heat, but should be OK in terms of n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
2016-10-02 moved connectors further up to get proper space for SD card.
2016-10-02 switched the pins on the SD card header for easier routing. PLaced the SD card header in the PCB
    [SDtop.SchDoc]
2016-10-02 Routed preliminary SD card, did pin swapping to achieve easy routing. Routed USB connectors for MCU
    [SDtop.SchDoc, XC7A35TFTG256_bank34.SchDoc]
2016-10-02 pinwswapped in bank 34 to get better routing for SD, added net names to Reserve USB1 pins on uC
    [XC7A35TFTG256_bank34.SchDoc, XC7A35TFTG256_bank35.SchDoc]
2016-10-02 routed reserve wires for USB1.1. Needed to move EBI.D lines in order to get hold of the reserve wires
2016-10-02 most components are positioned now. Remaining are: LEDS, some TVS-diodes for the USB lines and some resistors/capacitors for the mode and debug wiring. Remaining wiring on the FPGA is: Config memory 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
2016-10-02 added 3-way header for redundancy for LEDs voltage supply level
    [LED.SchDoc]
2016-10-02 routed MCU leds, pin swapping to get good routing. Routed extra pins on FPGA
    [LED.SchDoc]
2016-10-02 Preliminary routing completed, pin swapped leds to get easier routing. Not rule checked
    [LED.SchDoc]
2016-10-02 Added more intuitive names to FPGA-leds
    [LED.SchDoc]
2016-10-02 minor fixes done to pcb, lots of small things still left to fix
2016-10-02 switched to correct regulator package
    [Power.SchDoc]
2016-10-02 most of the unrouted net issues are sorted out (not all)
    [DMPro16.PrjPcb]
2016-10-02 updated output job to output 3d pdf file. Updated full schematic print
2016-10-02 updated sheet numbering and added template to UART connect sheet
    [Connectors.SchDoc, EFM32_IO.SchDoc, EFM32_power.SchDoc, LED.SchDoc, MCUtop.SchDoc, N25Q128A13ESE40.SchDoc, Power.SchDoc, SDtop.SchDoc]
2016-10-02 generated new, up to date schematic prints
2016-10-02 added new outputjob for production files. Rearranged folders holding the documentation
    [DMPro16.PrjPcb]
2016-10-02 generated version 0.1 gerber and documentation
    [pcb.GBL, pcb.GBO, pcb.GBP, pcb.GBS, pcb.GKO, pcb.GTL, pcb.GTO, pcb.GTP]
2016-10-04 updated version number and Board name in prject settings
    [DMPro16.PrjPcb]
2016-10-04 added board name to PCB, updated version number in silk
2016-10-04 updated rules to allow linear regulators to have 1mm thick thermal connectors. Minor adjustment to a few traces that collided with the thermal pad.
2016-10-04 removed all project outputs from folder to have clean slate for new files. Needed to clean up folders in project outputs
    [pcb.GBL, pcb.GBO, pcb.GBP, pcb.GBS, pcb.GKO, pcb.GTL, pcb.GTO, pcb.GTP]
2016-10-04 generated documentation and production files for release 0.2
    [pcb.GBL, pcb.GBO, pcb.GBP, pcb.GBS, pcb.GKO, pcb.GTL, pcb.GTO, pcb.GTP]
2016-10-04 Fixed error in silk (wrong name on proejct participant), updated version references and silk
    [DMPro16.PrjPcb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]
2016-10-05 updated revision number to 0.4
    [DMPro16.PrjPcb]
2016-10-05 Added proper logo to pcb, minor tweaking to other silk lines as well. No other changes
2016-10-05 replaced old font with new, added dots to pacman trail between FPGA leds
2016-10-05 updated production files and documentation files for release 0.4
    [pcb.GTO]
2016-10-06 increased size of annular ring to 0.1 mm. Had to redraw some lines to resolve short circuit errors that arose as a result.
    [DMPro16.PrjPcb]
2016-10-06 generated docs and prod files for release 0.5
    [pcb.GBL, pcb.GBO, pcb.GBP, pcb.GBS, pcb.GKO, pcb.GTL, pcb.GTO, pcb.GTP]
2016-10-17 added pdf print of pcb
2016-10-17 Added bomdoc file. Not done with the BOM yet
    [DMPro16.PrjPcb]
2016-10-17 added new SD card component, since the previous one was unfindable on the market. Did initial routing, no DRC checks yet
    [SDtop.SchDoc]
2016-10-17 Performed DRC check, looks good.
    [DMPro16.PrjPcb]
2016-10-17 Added new solutions for most components. Replaced dip connector for mode selection because it was not available.
    [XC7A35TFTG256_bank0.SchDoc]
2016-10-17 added bom output job. Generated BOM and modified for sending. Have not added connectors yet
    [Bill of Materials-BOMDOC.csv, DMPro16.PrjPcb, Modified Bill of Materials.csv]
2016-10-18 removed unnecessary switch
    [XC7A35TFTG256_bank0.SchDoc]
2016-10-18 added ground connection to FT232 for test-pin. Not connected, but has to be in order to work
    [DMPro16.PrjPcb, UART_connect.SchDoc]
2016-10-18 wired test-pin to ground via a relatively long trace => possible to cut if needed
2016-10-18 changed version name to 1.0
    [DMPro16.PrjPcb]
2016-10-18 added new schematic prints for version 1.0
2016-10-18 Generated production files for version 1.0
    [pcb.GBL, pcb.GBO, pcb.GBP, pcb.GBS, pcb.GTL, pcb.GTO, pcb.GTP, pcb.GTS]
2016-10-18 Updated BOM, should be correct now
    [Modified Bill of Materials.csv]
2016-11-23 Added explicit showing of part number on oscillators for easier use of schematic
    [EFM32_IO.SchDoc, XC7A35TFTG256_bank35.SchDoc]
